MitkoDyakov/Calipatron/README.md

# Calipatorn
I design my own digital caliper based on STM32F103C8T6 blue pill.
