MitkoDyakov/Calipatron/Documents/time.png

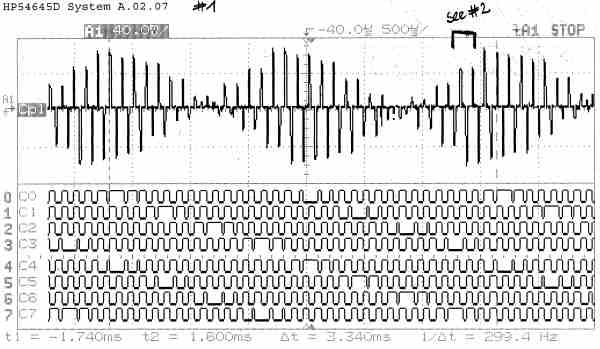
Documents/time.png
