MitkoDyakov/Calipatron/Hardware/V2/blade.step

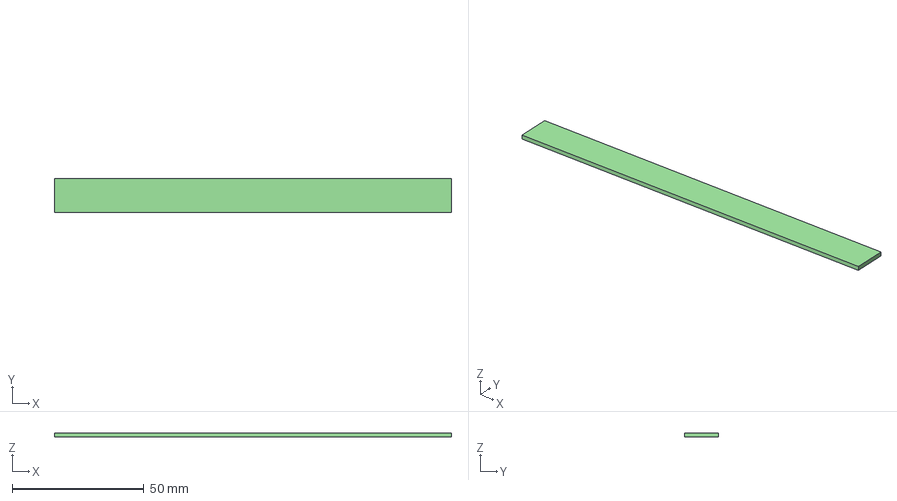
[picture p9: CAD file, 2026-01-22]
Hardware/V2/blade.step
150.6 x 13.0 x 1.60 mm
