MitkoDyakov/Calipatron/Hardware/V2/Res/ADR510ARTZ-REEL7/ADR510ARTZ-REEL7.step

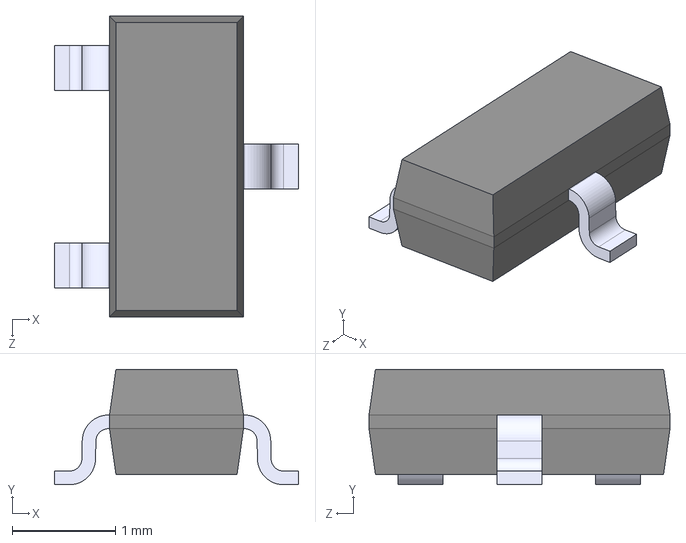
[picture p10: CAD file, 2026-01-22]
Hardware/V2/Res/ADR510ARTZ-REEL7/ADR510ARTZ-REEL7.step
2.37 x 1.12 x 2.92 mm
