MitkoDyakov/Calipatron/Hardware/V2/Res/button/3-1437565-0.step

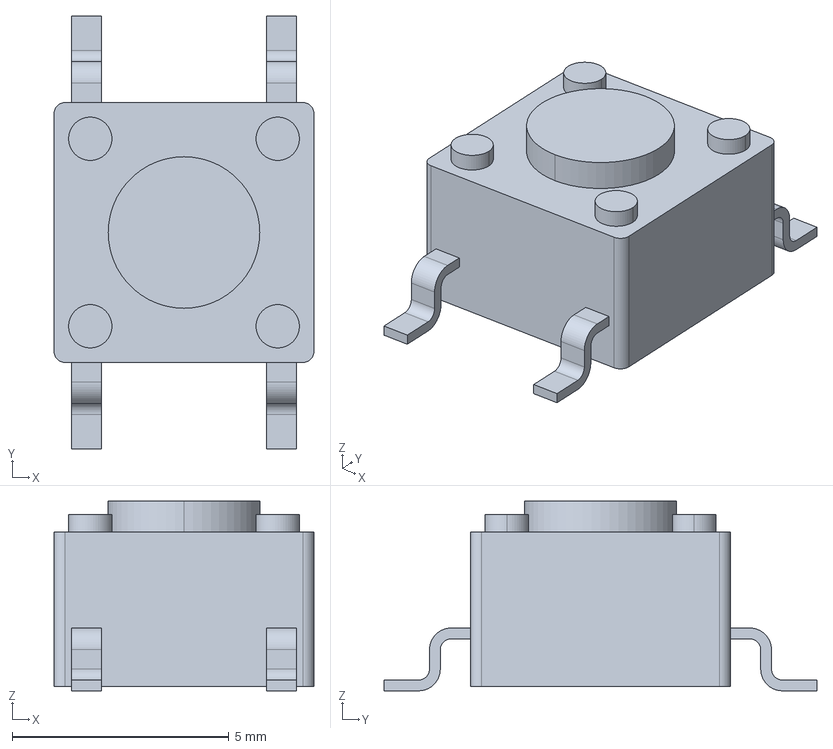
[picture p11: CAD file, 2024-04-25]
Hardware/V2/Res/button/3-1437565-0.step
6.00 x 10.0 x 4.38 mm
