MitkoDyakov/Calipatron/Hardware/V2/Res/HRO_TYPE-C-31-M-12.step

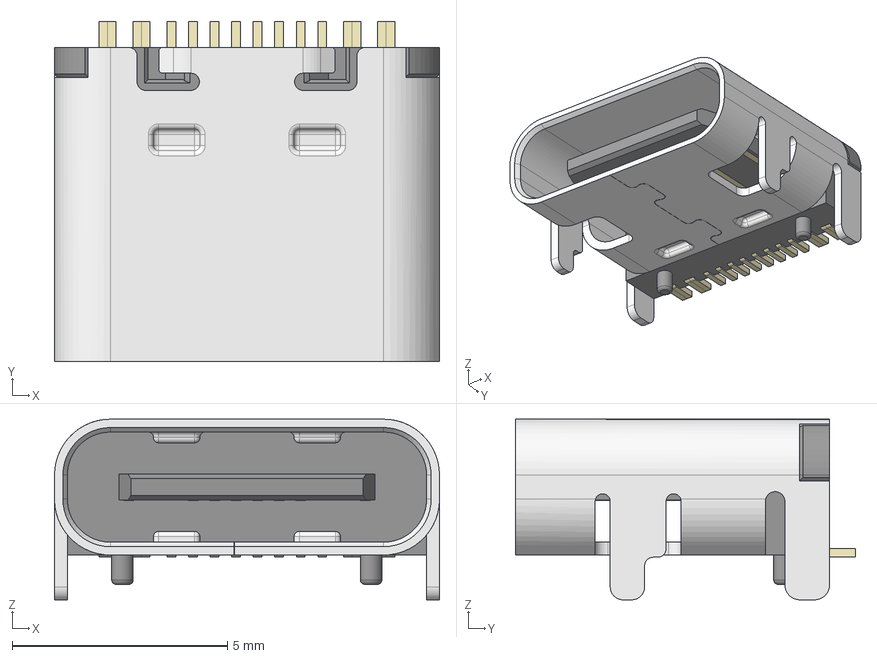
[picture p12: CAD file, 2024-04-25]
Hardware/V2/Res/HRO_TYPE-C-31-M-12.step
8.95 x 7.90 x 4.20 mm
