MitkoDyakov/Calipatron/Hardware/V2/Res/MC-306_32.7680K-A__ROHS/MC-306_32.7680K-A__ROHS.step

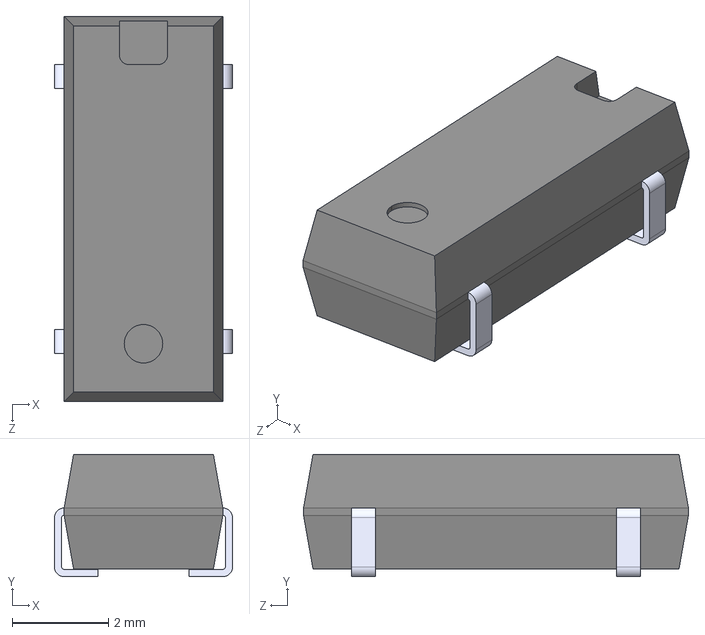
[picture p13: CAD file, 2024-04-25]
Hardware/V2/Res/MC-306_32.7680K-A__ROHS/MC-306_32.7680K-A__ROHS.step
3.70 x 2.54 x 8.00 mm
