MitkoDyakov/Calipatron/Hardware/V2/Res/MCP6S21-I_SN/MCP6S21-I_SN.step

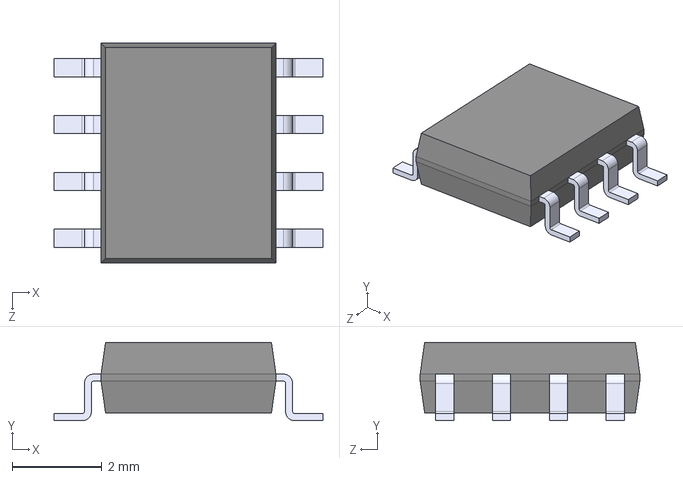
[picture p14: CAD file, 2026-01-22]
Hardware/V2/Res/MCP6S21-I_SN/MCP6S21-I_SN.step
6.00 x 1.75 x 4.90 mm
