MitkoDyakov/Calipatron/Hardware/V2/Res/TSM-104-02-X-SH/TSM-104-02-X-SH.step

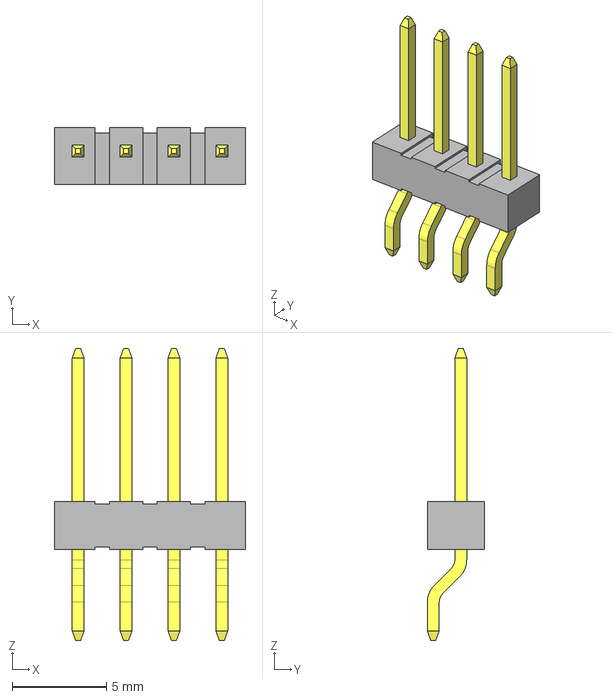
[picture p15: CAD file, 2024-04-25]
Hardware/V2/Res/TSM-104-02-X-SH/TSM-104-02-X-SH.step
10.2 x 3.05 x 15.5 mm
TSM-104-02-SH_body
T-1S6-15(-02-4-SH)
