MitkoDyakov/Calipatron/Hardware/V2/Res/XIAO/ABM3-10.0000MHZ-D2Y-T--3DModel-STEP-400430.STEP

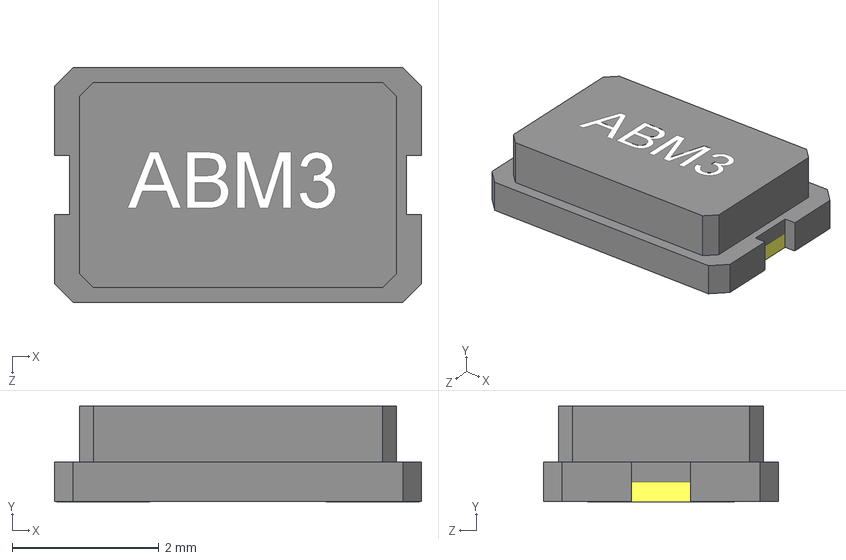
[picture p16: CAD file, 2024-04-25]
Hardware/V2/Res/XIAO/ABM3-10.0000MHZ-D2Y-T--3DModel-STEP-400430.STEP
5.00 x 1.30 x 3.20 mm
