MitkoDyakov/Calipatron/Hardware/V1.0/Step/clip.step

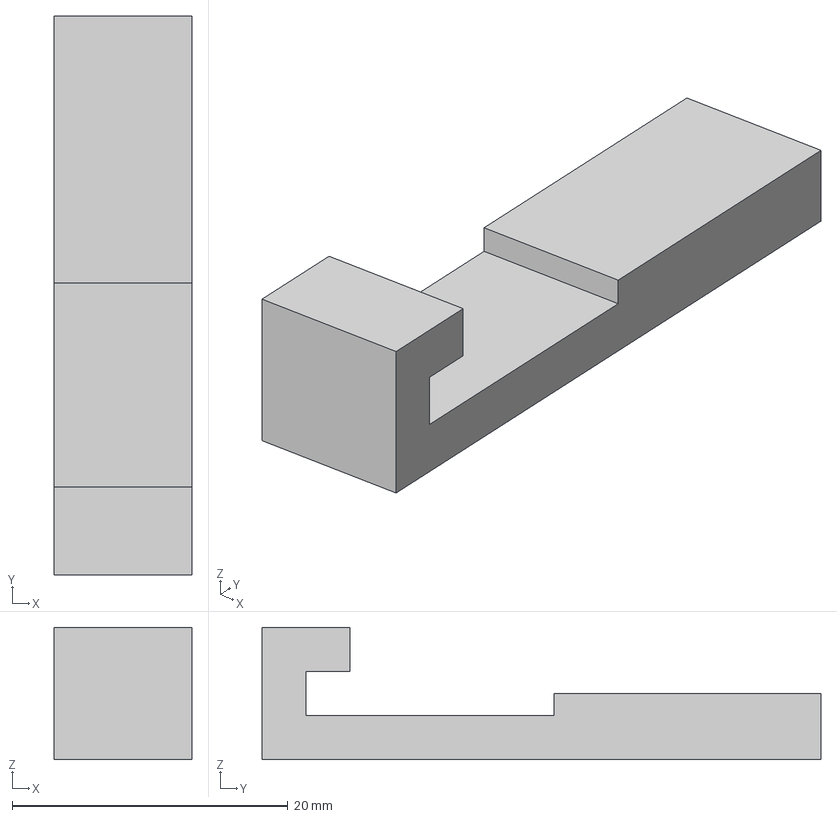
[picture p17: CAD file, 2024-02-12, an earlier design]
Hardware/V1.0/Step/clip.step
10.0 x 40.6 x 9.60 mm
