MitkoDyakov/Calipatron/Hardware/V1.1/Step/CaliperBlade.step

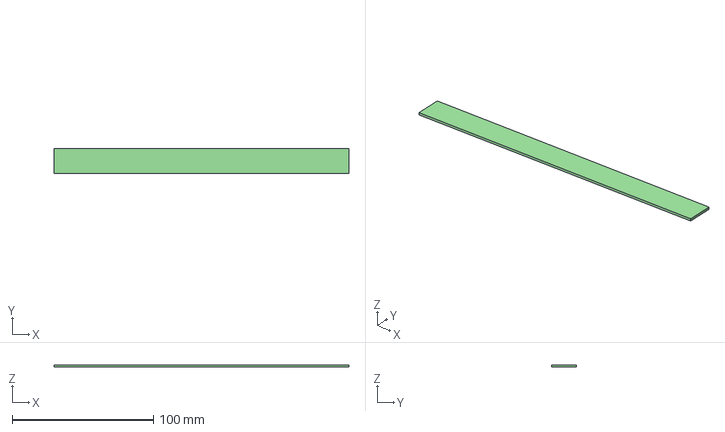
[picture p18: CAD file, 2024-02-12, an earlier design]
Hardware/V1.1/Step/CaliperBlade.step
208.8 x 18.0 x 1.60 mm
