MitkoDyakov/Calipatron/Hardware/V1.2/Step/CaliperBlade.step

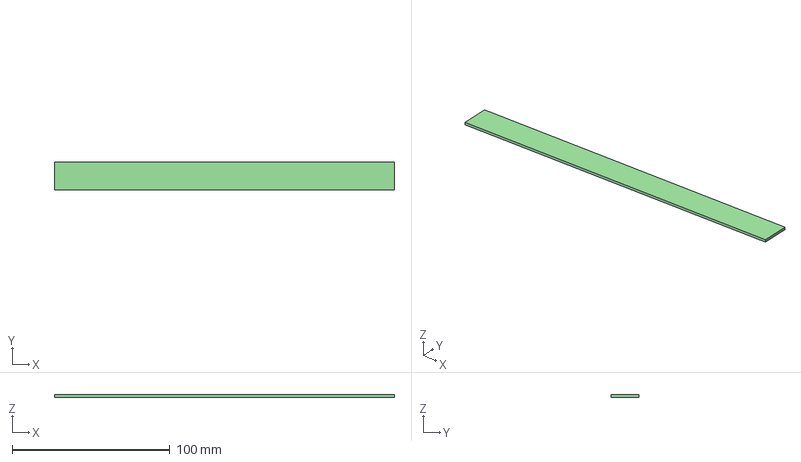
[picture p19: CAD file, 2024-09-15, an earlier design]
Hardware/V1.2/Step/CaliperBlade.step
215.8 x 18.0 x 1.60 mm
