MitkoDyakov/Calipatron/(list of files, cad)

Other CAD files:
Hardware/V1.0/Step/clip.stl
