MitkoDyakov/Calipatron/Software/binary/howto.png

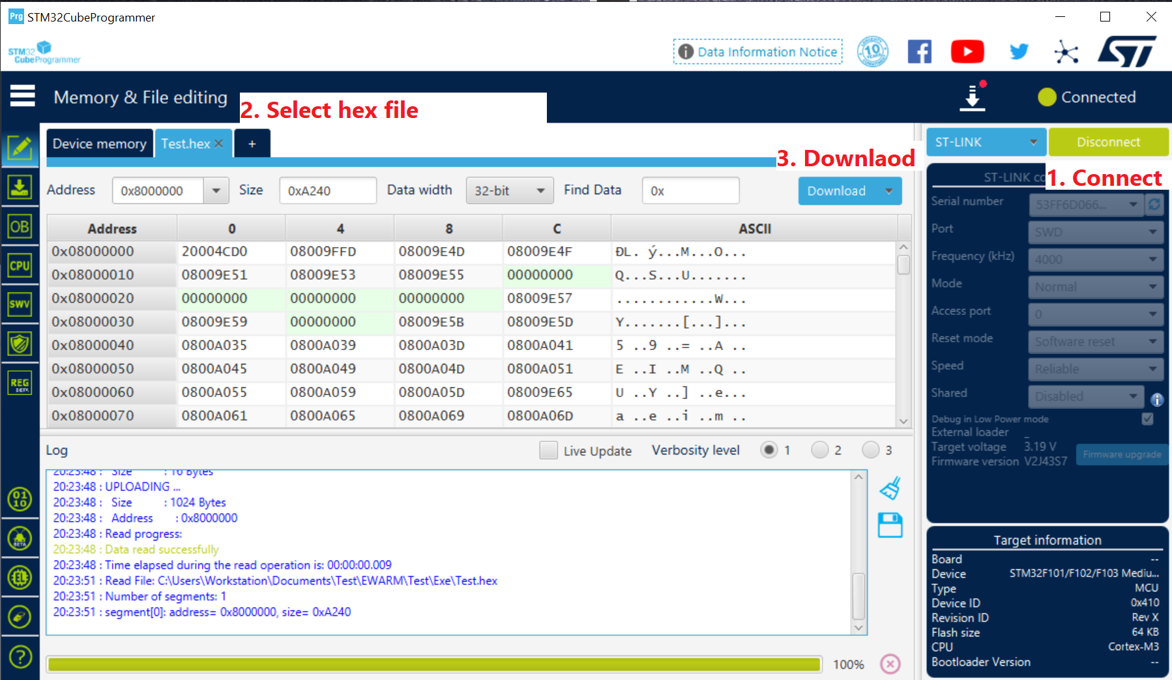
Software/binary/howto.png
