MitkoDyakov/Calipatron/Documents/yadro_timemachine.pdf

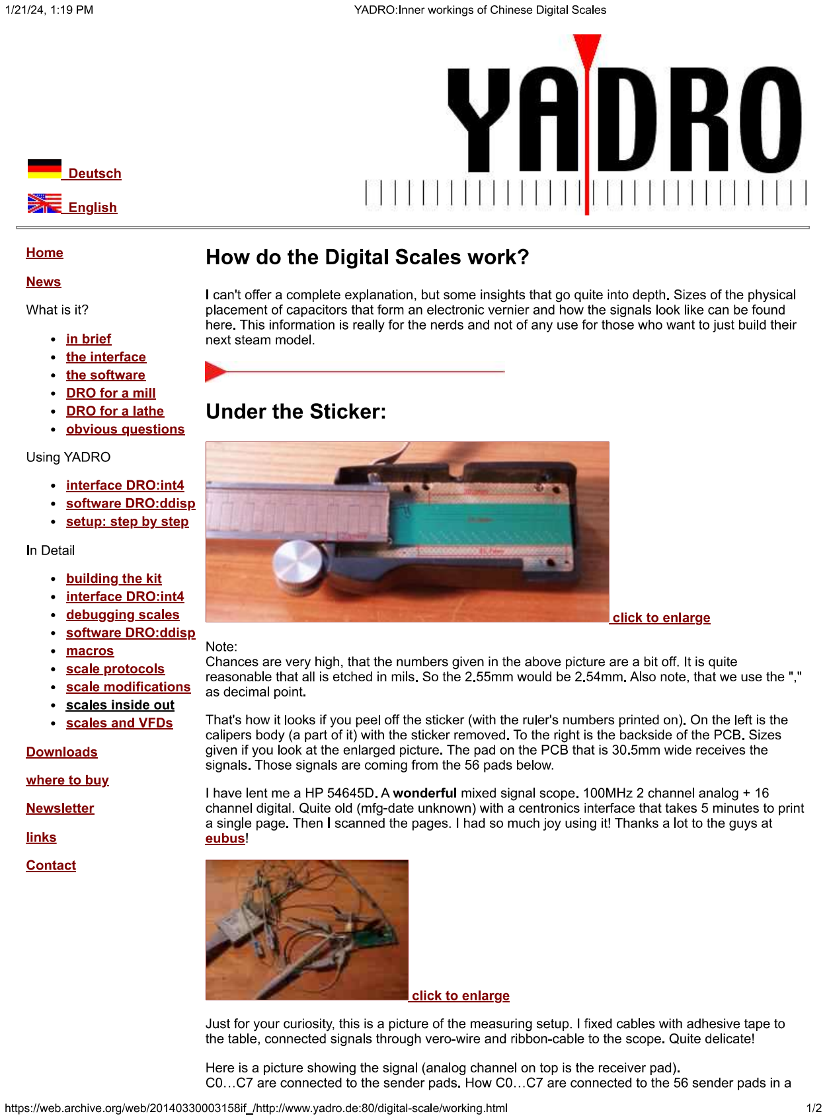
[picture p21: page 1]

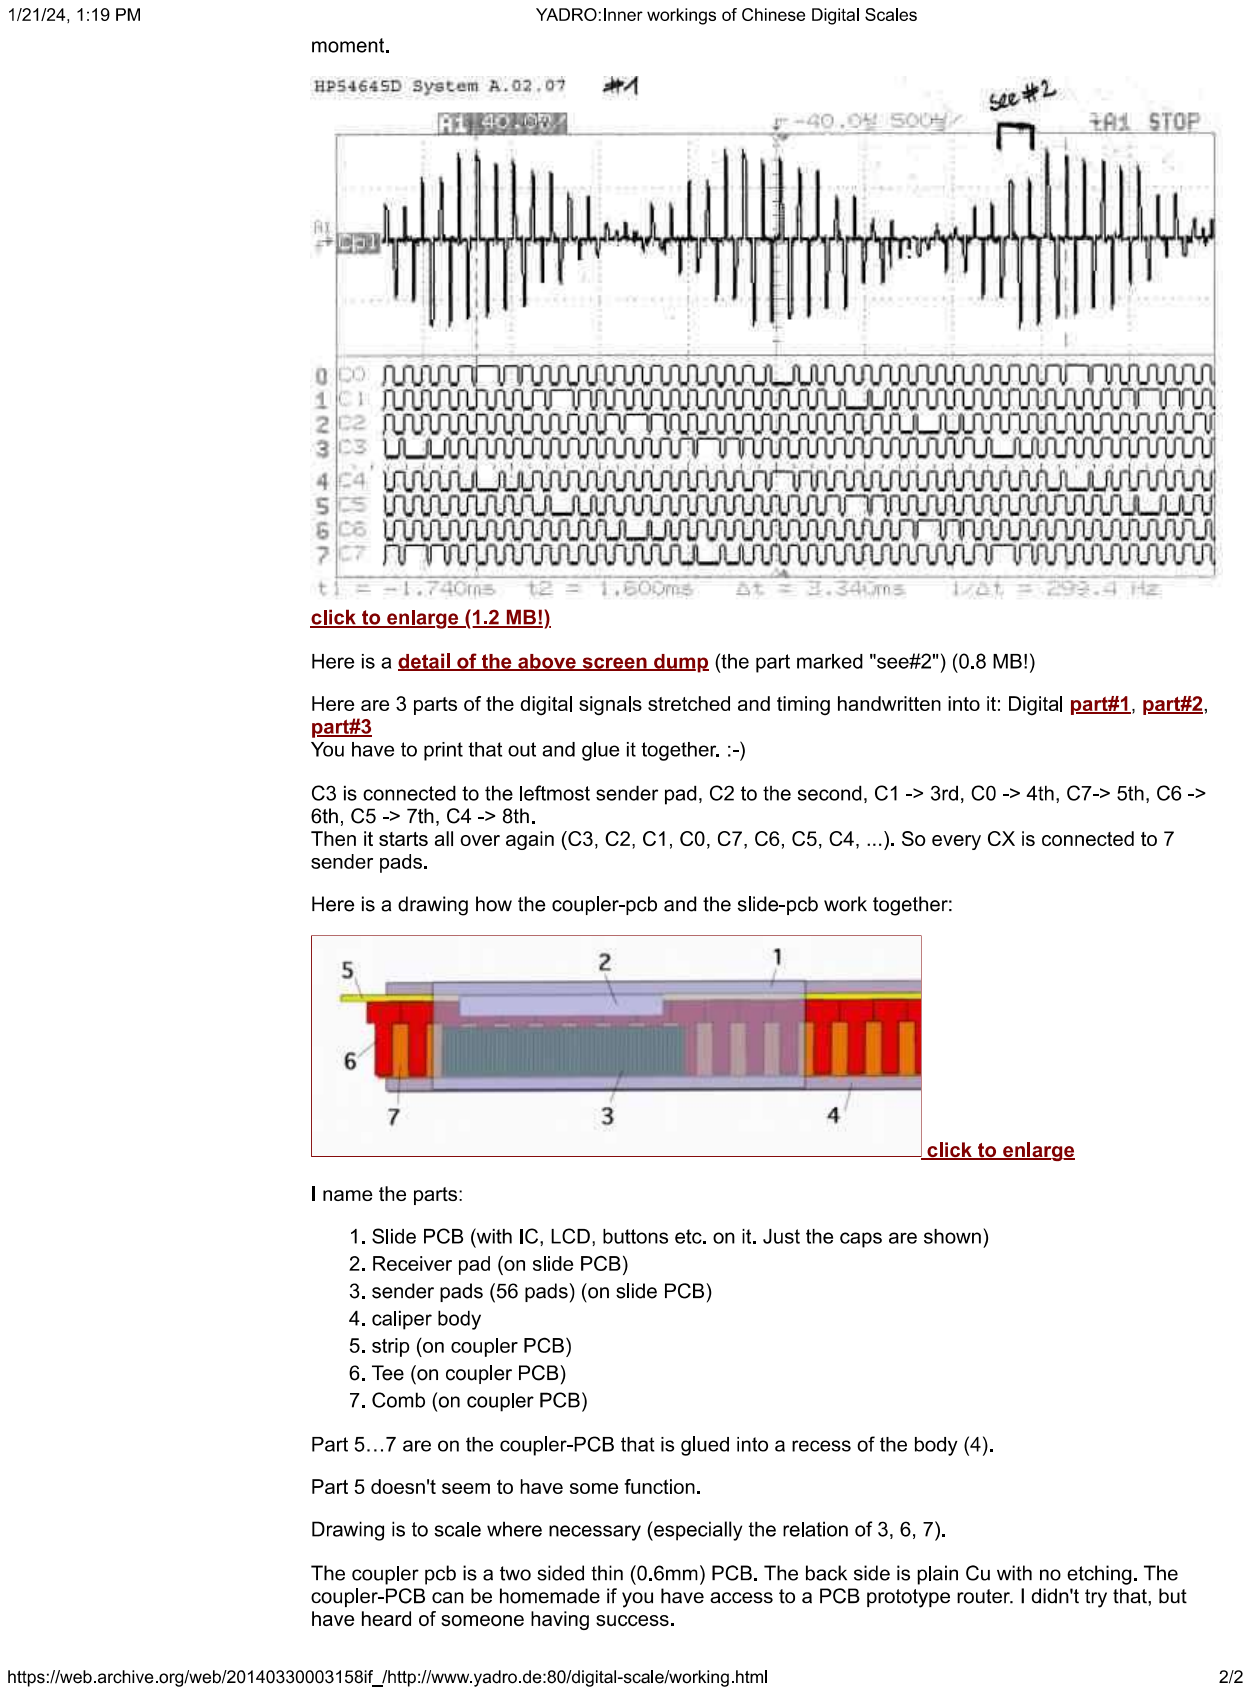
[picture p22: page 2]
