MitkoDyakov/Calipatron/Hardware/V1.2/Schematics V1.2.pdf

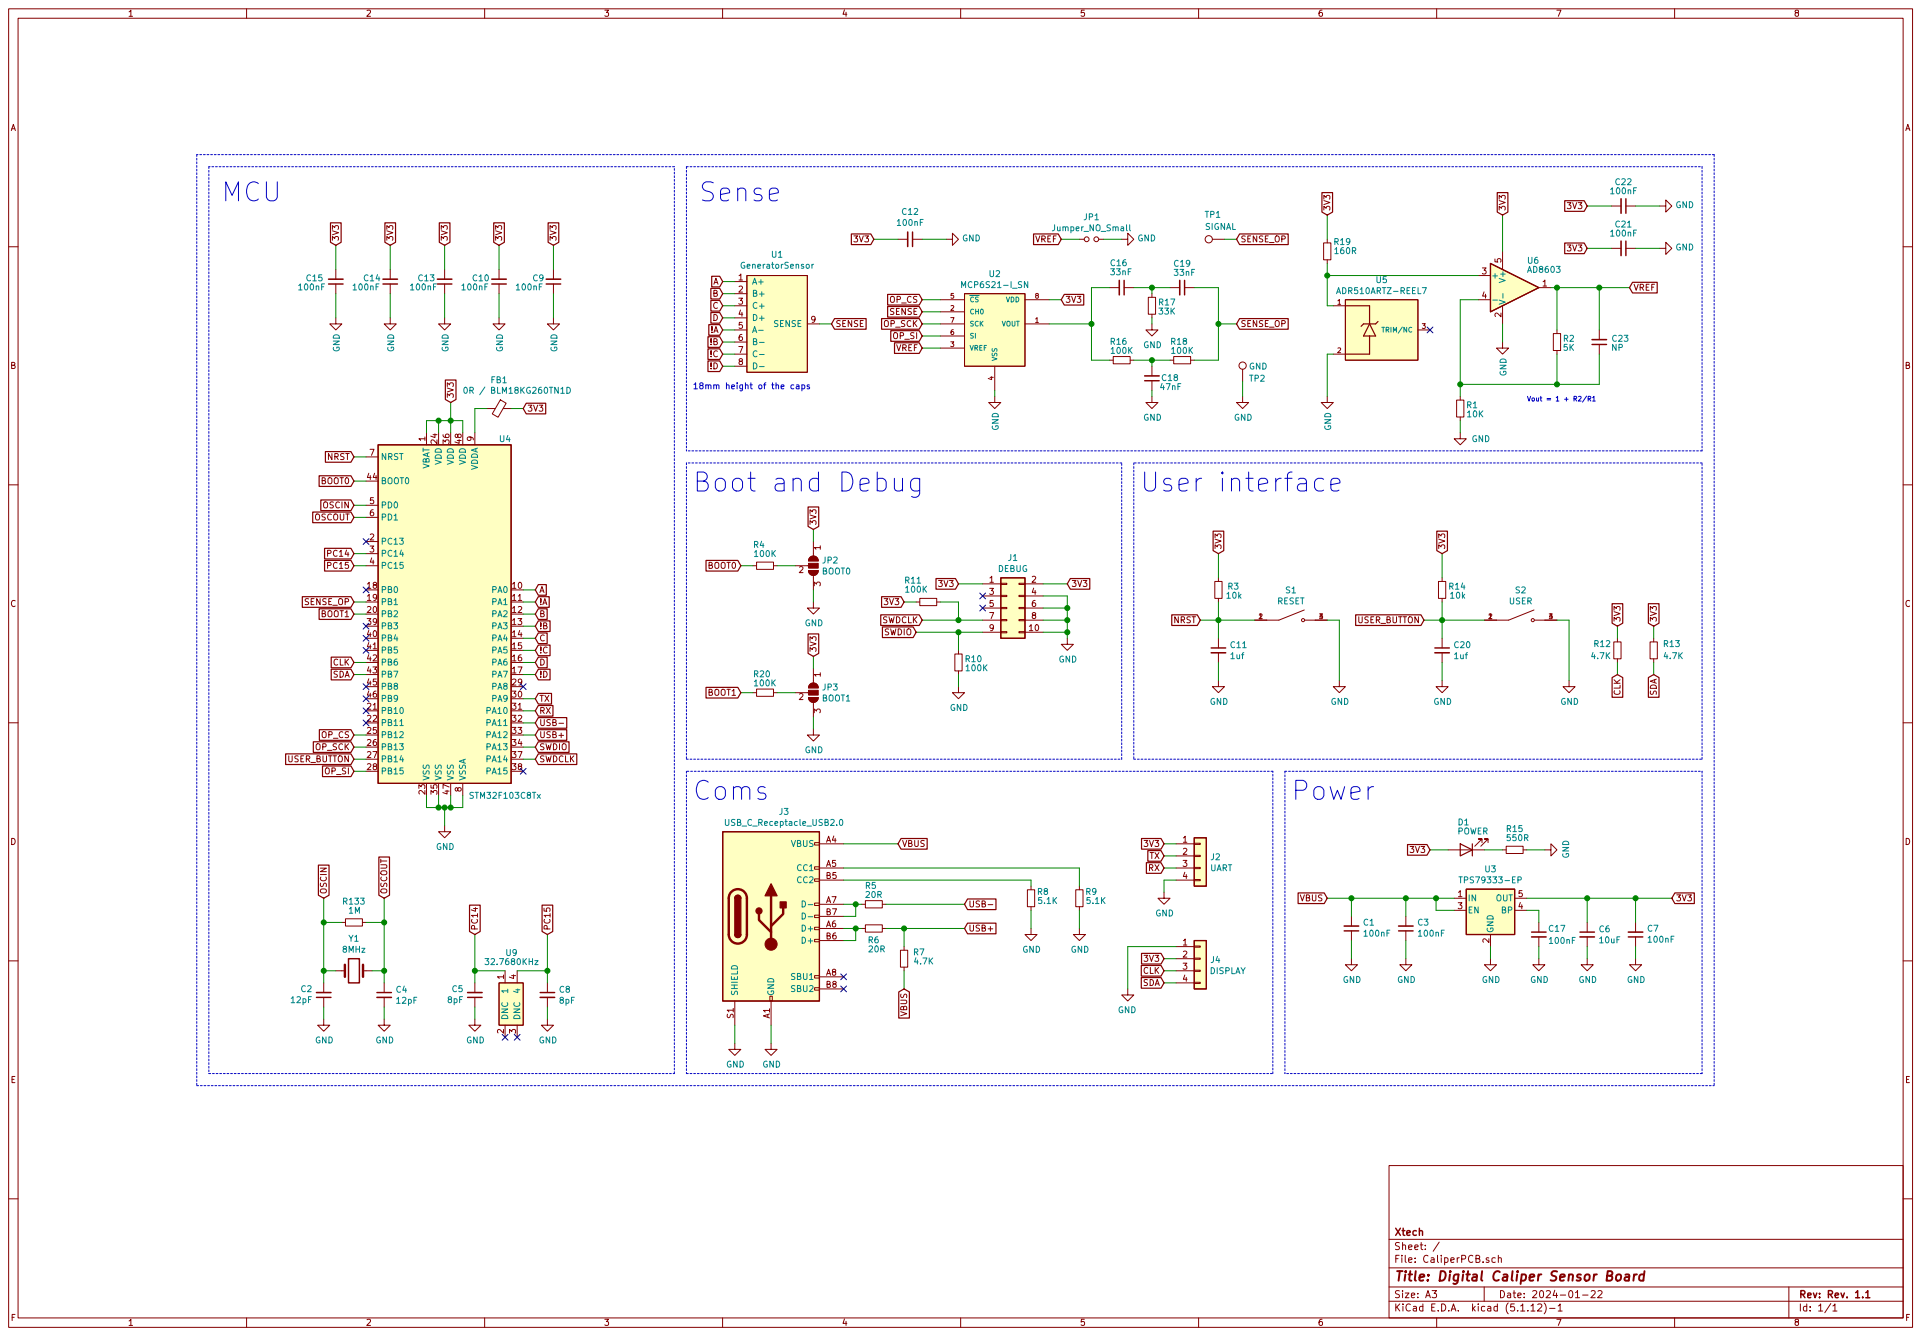
[picture p23: page 1]

4 CS 5 SI 6 SCK 7 VDD 8 U2 MCP6S21-I_SN

1 VDD 24 VDD 36 VDD 48 VDDA

9 VSS 23 VSS 35 VSS 47 VSSA

2 EN 3 BP 4 OUT 5 U3 TPS79333-EP

File: CaliperPCB.sch Sheet: / Xtech

Id: 1/1 Title: Digital Caliper Sensor Board
