MitkoDyakov/Calipatron/Hardware/V1.2/Placement V1.2.pdf

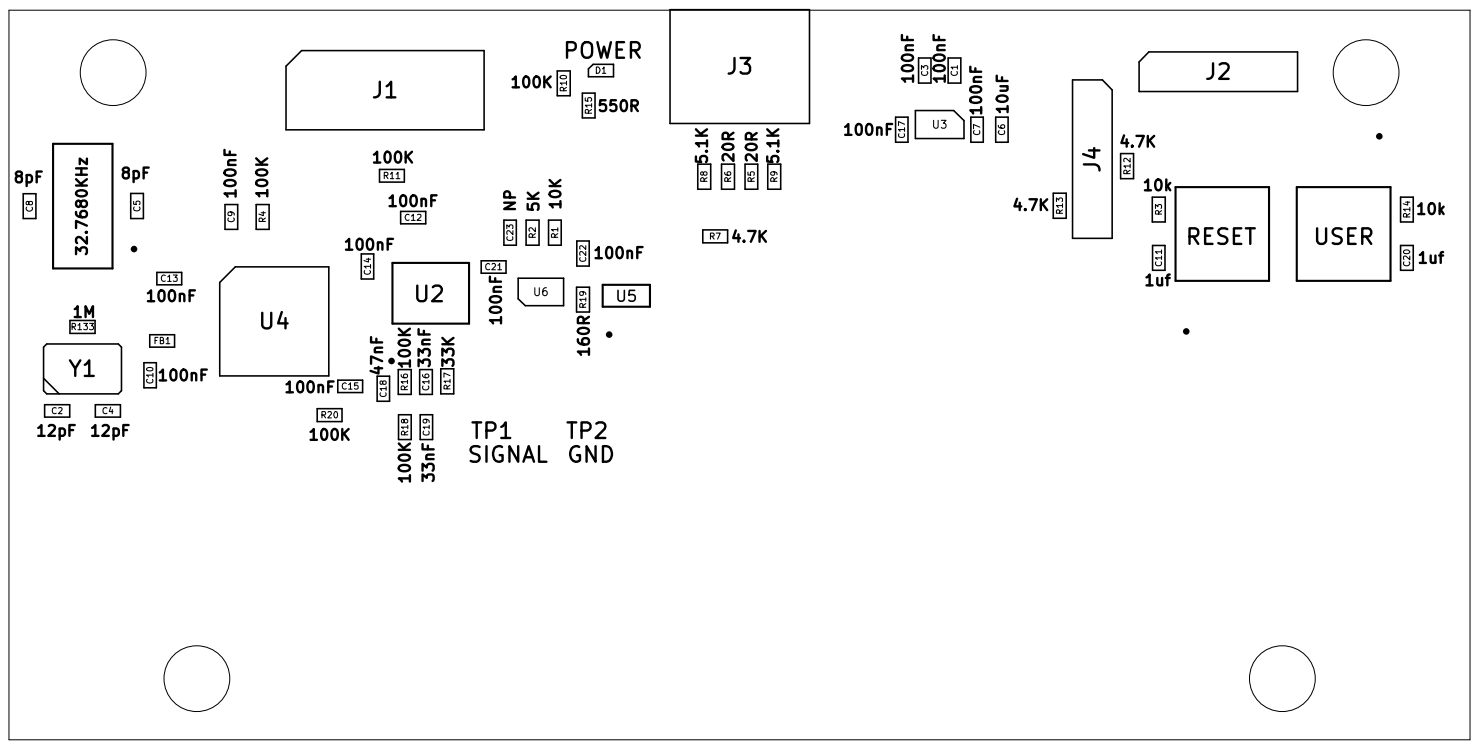
[picture p24: page 1]
