MitkoDyakov/Calipatron/Hardware/V1.1/Placement V1.1.pdf

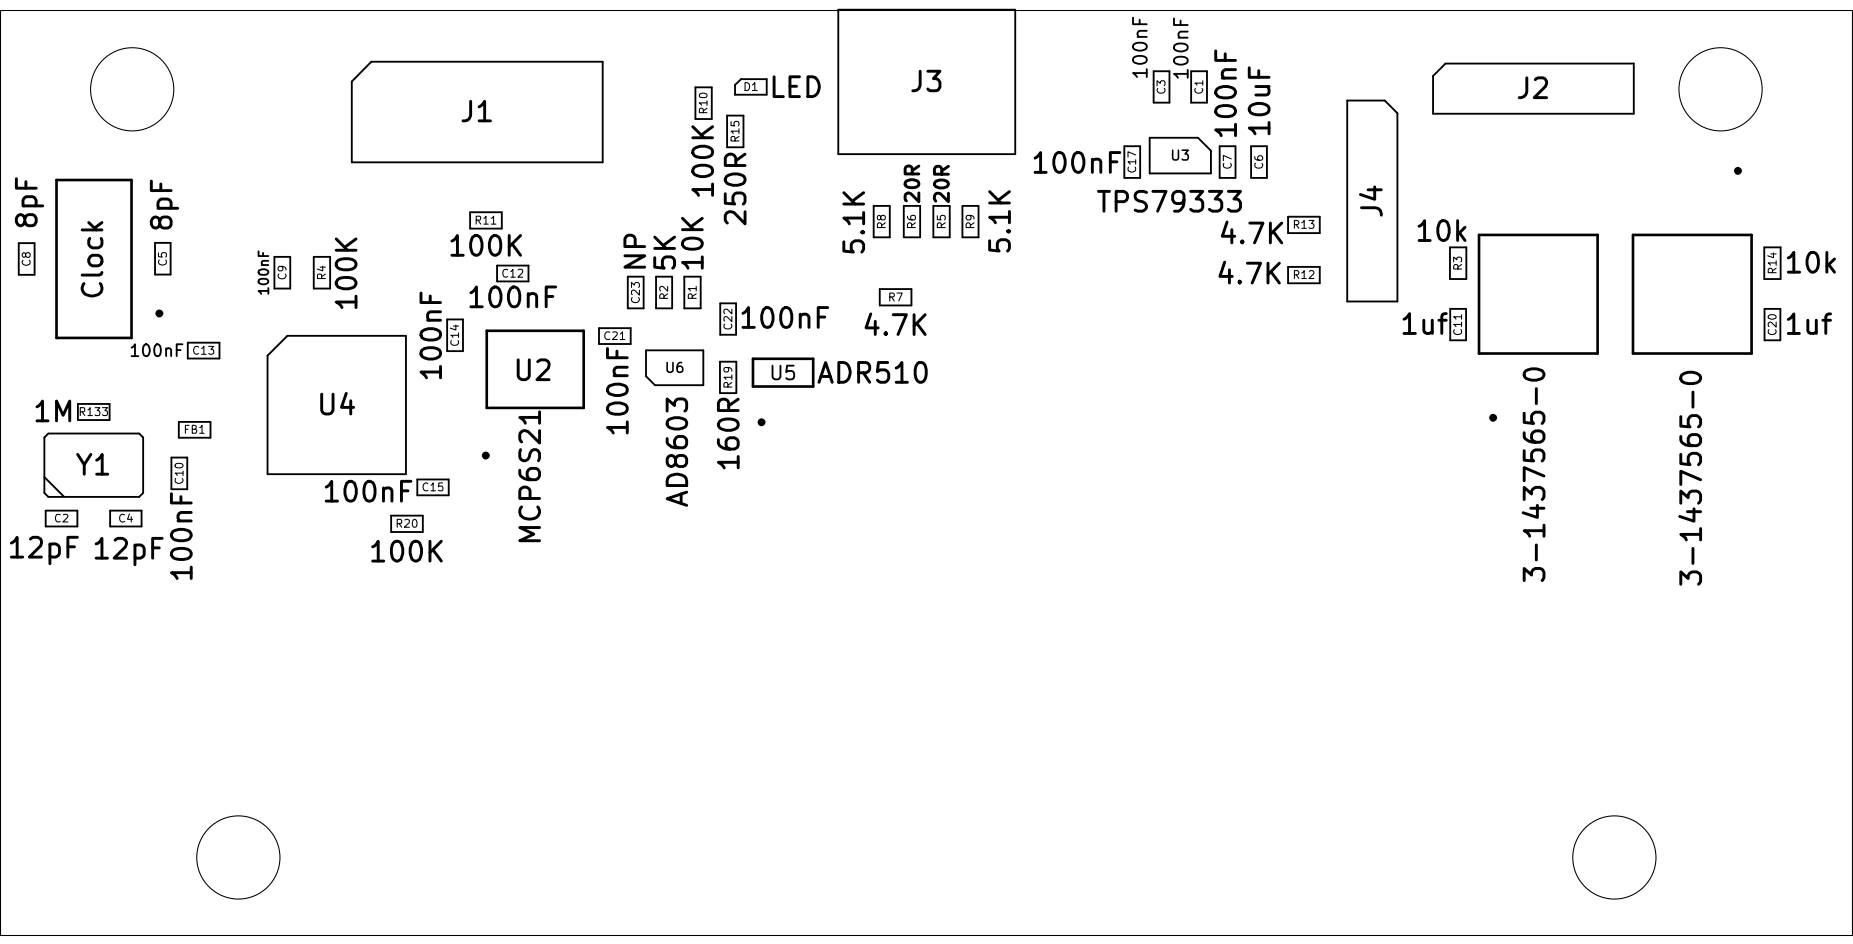
[picture p25: page 1]
