MitkoDyakov/Calipatron/Hardware/V1.0/Caliper BOM and placement V1.pdf

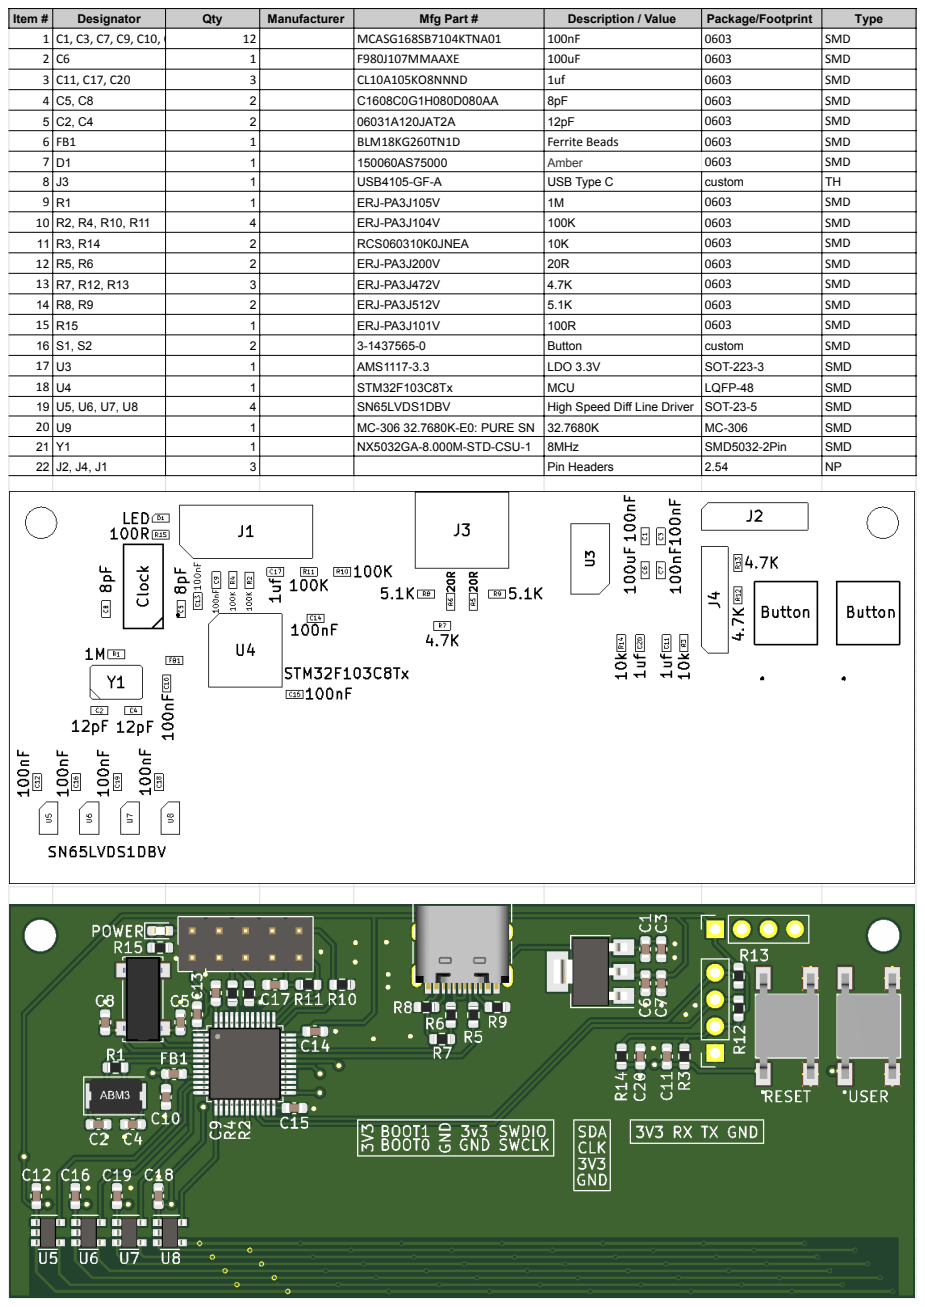
[picture p26: page 1]
