MitkoDyakov/Calipatron/Hardware/V1.0/Schematics V1.pdf

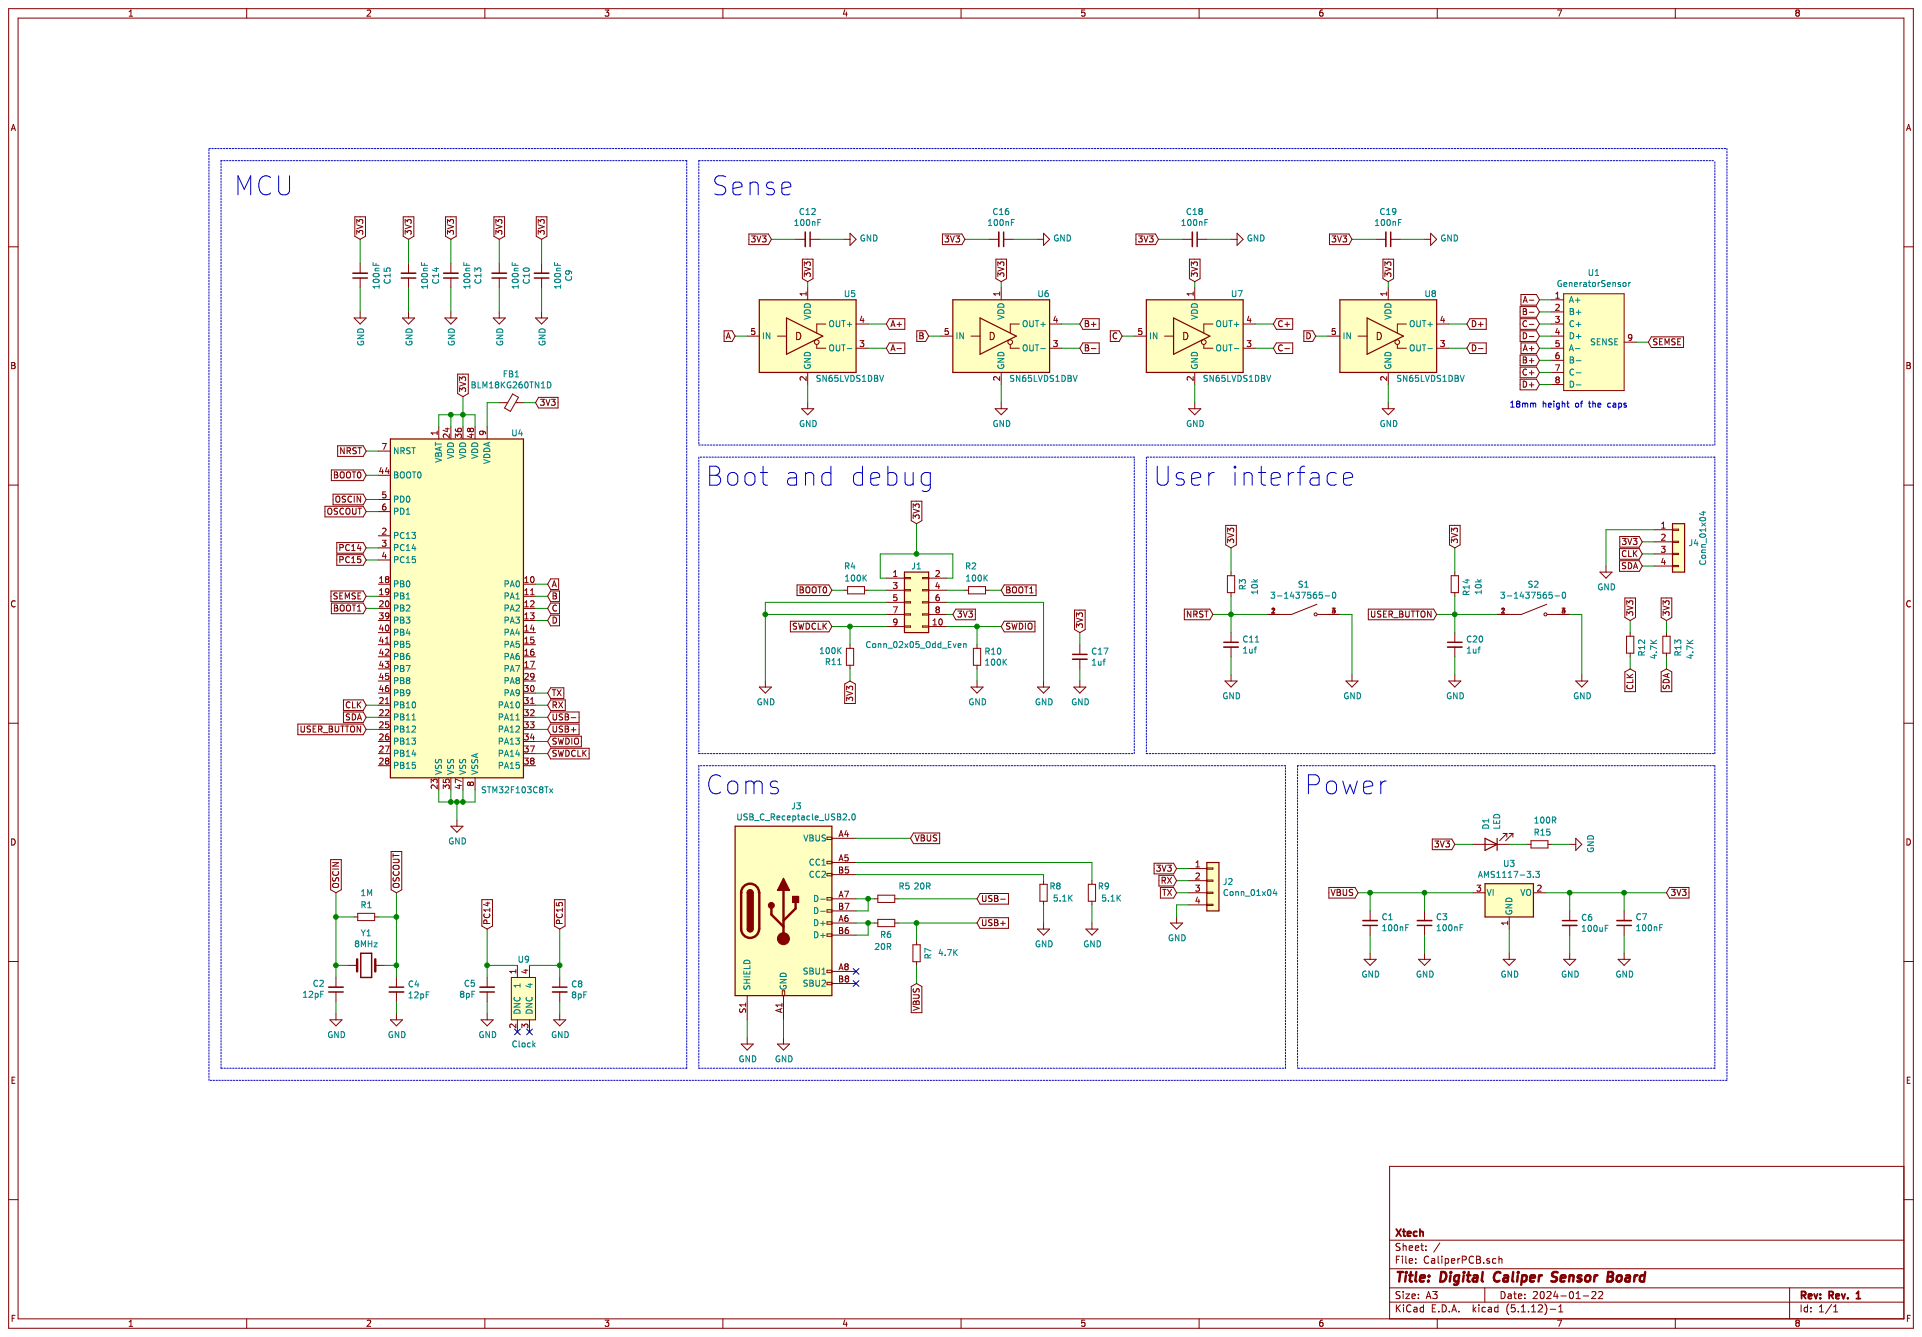
[picture p27: page 1]
