MitkoDyakov/Calipatron/Hardware/V2/Res/XIAO/XIAO ESP32 C6.kicad_pcb

## KiCad design Hardware/V2/Res/XIAO/XIAO ESP32 C6.kicad_pcb (2026-01-22)

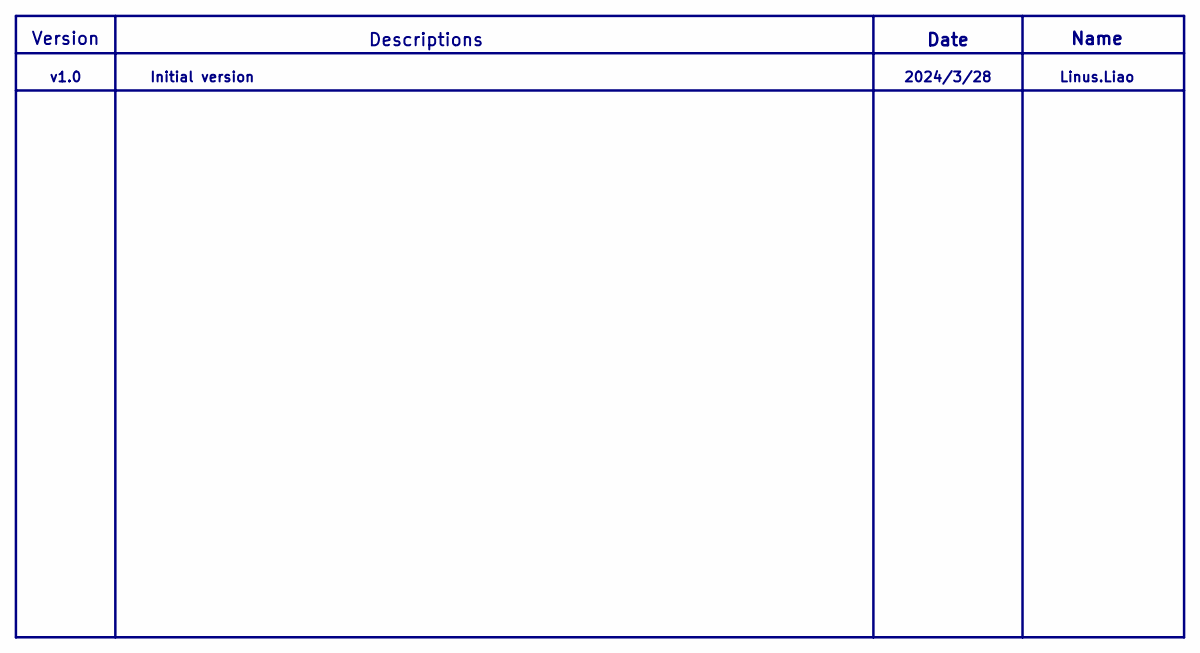
[picture p28: schematic 01 Descriptions.kicad_sch]

Notes on the sheet:
Date
Descriptions
Linus.Liao
2024/3/28
v1.0
Initial version
Name
Version

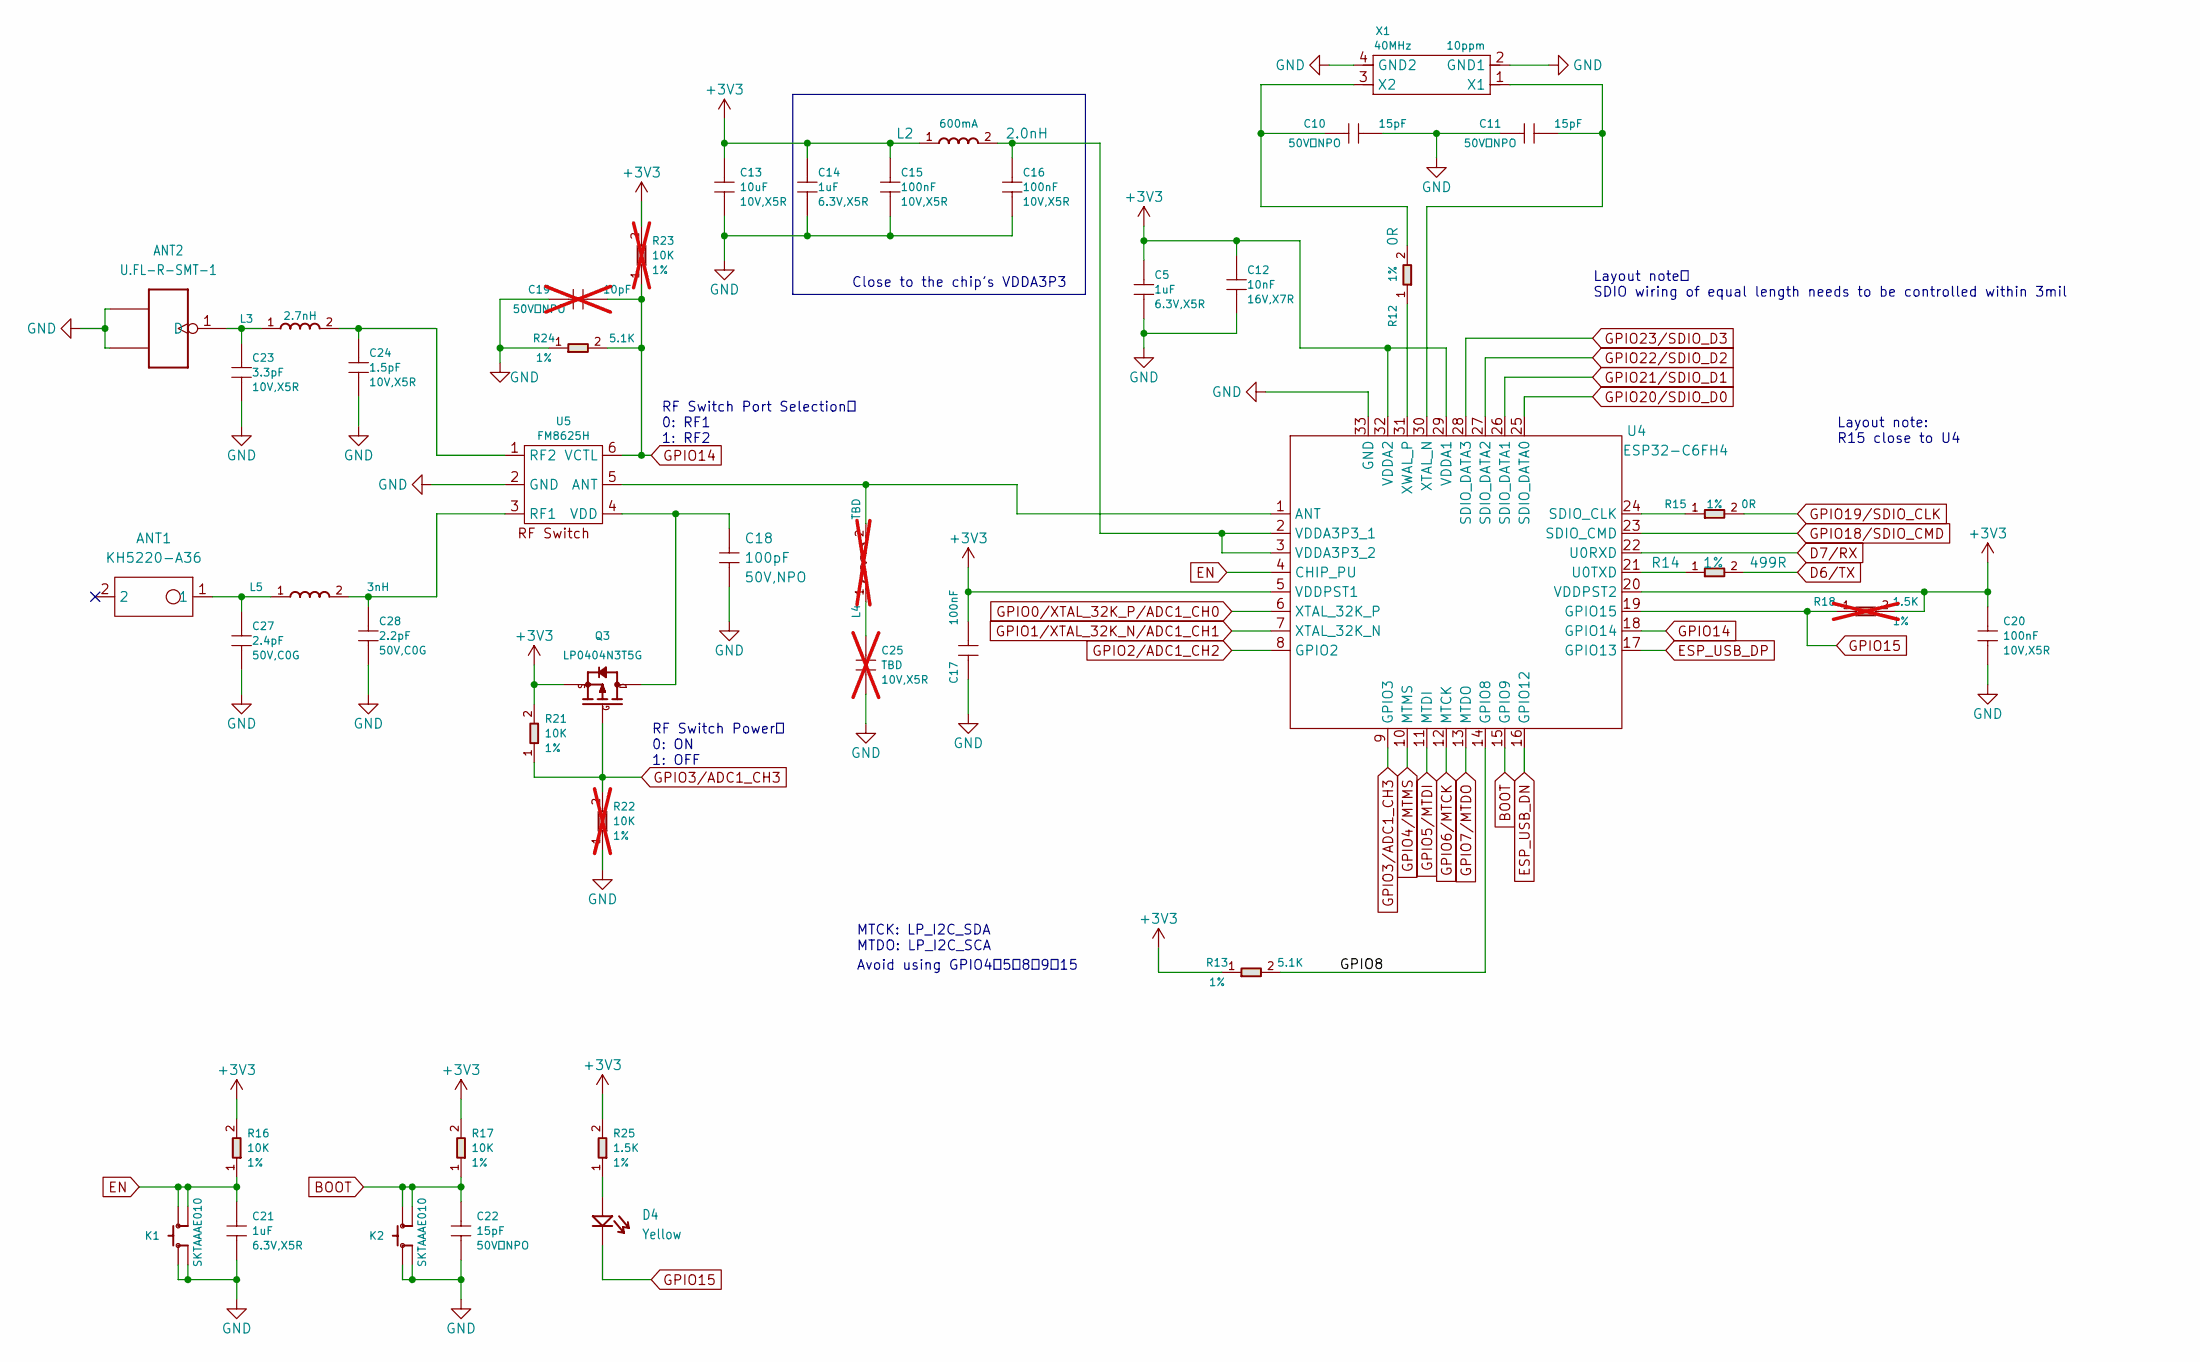
[picture p29: schematic 04 ESP32 C6.kicad_sch]

Parts:
ANT1: KH5220-A36; ANT2P-5.2x2x1.1MM; MPN KH5220-A36
ANT2: U.FL-R-SMT-1; U-FL3P-SMD-2.6X2.6X1.0MM; MPN U.FL-R-SMT-1
C5, C14, C21: 1uF; C0201; Voltage Rating 6.3V,X5R; MPN CC0201MRX5R5BB105
C10, C11, C22: 15pF; C0201; Voltage Rating 50V，NPO; MPN CC0201JRNPO9BN150
C12: 10nF; C0201; Voltage Rating 16V,X7R; MPN CC0201KRX7R7BB103
C13: 10uF; C0402; Voltage Rating 10V,X5R; MPN CC0402MRX5R6BB106
C15, C16, C17, C20: 100nF; C0201; Voltage Rating 10V,X5R; MPN CC0201KRX5R6BB104
C18: 100pF; C0201; Voltage Rating 50V,NPO; MPN CC0201JRNPO9BN101
C19: 10pF; C0201; Voltage Rating 50V，NPO; MPN CC0201JRNPO8BN100; not fitted
C23: 3.3pF; C0201; Voltage Rating 10V,X5R; MPN CQ0201BRNPO8BN3R3
C24: 1.5pF; C0201; Voltage Rating 10V,X5R; MPN CC0201BRNPO9BN1R5
C25: TBD; C0201; Voltage Rating 10V,X5R; Part Type Ceramic; not fitted
C27: 2.4pF; C0201; Voltage Rating 50V,C0G; MPN GRM0335C1H2R4BA01D
C28: 2.2pF; C0201; Voltage Rating 50V,C0G; MPN GRM0335C1H2R2BA01D
D4: Yellow; LED-0402; MPN 16-213/Y2C-AN2Q1B/3T
K1, K2: SKTAAAE010; SW4-SMD-2.8-2.6X1.6X0.53MM; MPN SKTAAAE010
L2: 2.0nH; L0201; Rating 600mA; MPN LQP03HQ2N0B02D
L3: 2.7nH; L0201; MPN LQP03TN2N7B02D
L4: TBD; L0201; Part Type L; not fitted
L5: 3nH; L0201; MPN LQP03TN3N0B02D
Q3: LP0404N3T5G; PMOS_1.0X0.6X0.35MM; MPN LP0404N3T5G
R12, R15: 0R; R0201; Power Rating 1%; MPN RC0201FR-070RL
R13, R24: 5.1K; R0201; Power Rating 1%; MPN RC0201FR-075K1L
R14: 499R; R0201; Power Rating 1%; MPN RC0201FR-07499RL
R16, R17, R21: 10K; R0201; Power Rating 1%; MPN RC0201FR-0710KL
R18: 1.5K; R0201; Power Rating 1%; MPN RC0201FR-071K5L; not fitted
R22, R23: 10K; R0201; Power Rating 1%; MPN RC0201FR-0710KL; not fitted
R25: 1.5K; R0201; Power Rating 1%; MPN RC0201FR-071K5L
U4: ESP32-C6FH4; QFN32-0.5-5X5MM; MPN ESP32-C6FH4
U5: FM8625H; DFN6-0.4-1.1X0.7X0.45MM; MPN FM8625H
X1: 40MHz; X4-SMD-1.6X1.2MM; Rating 10ppm; MPN CJ17-400001010B20

Connections:
+3V3: C5.1, C12.1, C13.1, C14.1, C15.1, C17.1, C20.1, L2.1, Q3.2 (S), R13.1, R16.2, R17.2, R18.2, R21.2, R23.2, R25.2, U4.5 (VDDPST1), U4.20 (VDDPST2), U4.29 (VDDA1), U4.32 (VDDA2); also elsewhere on the board
/04 ESP32 C6/GPIO8: R13.2, U4.14 (GPIO8)
BOOT: C22.1, K2.3 (B0), K2.4 (B1), R17.1, U4.15 (GPIO9); also elsewhere on the board
D6/TX: R14.2; also elsewhere on the board
D7/RX: U4.22 (U0RXD); also elsewhere on the board
EN: C21.1, K1.3 (B0), K1.4 (B1), R16.1, U4.4 (CHIP_PU); also elsewhere on the board
ESP_USB_DN: U4.16 (GPIO12); also elsewhere on the board
ESP_USB_DP: U4.17 (GPIO13); also elsewhere on the board
GND: ANT2.2 (GND1), ANT2.3 (GND2), C5.2, C10.2, C11.1, C12.2, C13.2, C14.2, C15.2, C16.2, C17.2, C18.2, C19.1, C20.2, C21.2, C22.2, C23.2, C24.2, C25.2, C27.2, C28.2, K1.1 (A0), K1.2 (A1), K2.1 (A0), K2.2 (A1), R22.1, R24.1, U4.33 (GND), U5.2 (GND), X1.2 (GND1), X1.4 (GND2); also elsewhere on the board
GPIO0/XTAL_32K_P/ADC1_CH0: U4.6 (XTAL_32K_P); also elsewhere on the board
GPIO1/XTAL_32K_N/ADC1_CH1: U4.7 (XTAL_32K_N); also elsewhere on the board
GPIO2/ADC1_CH2: U4.8 (GPIO2); also elsewhere on the board
GPIO3/ADC1_CH3: Q3.1 (G), R21.1, R22.2, U4.9 (GPIO3)
GPIO4/MTMS: U4.10 (MTMS); also elsewhere on the board
GPIO5/MTDI: U4.11 (MTDI); also elsewhere on the board
GPIO6/MTCK: U4.12 (MTCK); also elsewhere on the board
GPIO7/MTDO: U4.13 (MTDO); also elsewhere on the board
GPIO14: C19.2, R23.1, R24.2, U4.18 (GPIO14), U5.6 (VCTL)
GPIO15: D4.2 (-), R18.1, U4.19 (GPIO15)
GPIO18/SDIO_CMD: U4.23 (SDIO_CMD); also elsewhere on the board
GPIO19/SDIO_CLK: R15.2; also elsewhere on the board
GPIO20/SDIO_D0: U4.25 (SDIO_DATA0); also elsewhere on the board
GPIO21/SDIO_D1: U4.26 (SDIO_DATA1); also elsewhere on the board
GPIO22/SDIO_D2: U4.27 (SDIO_DATA2); also elsewhere on the board
GPIO23/SDIO_D3: U4.28 (SDIO_DATA3); also elsewhere on the board
unnamed: ANT1.1, C27.1, L5.1
unnamed: ANT2.1 (D), C23.1, L3.1
unnamed: C25.1, L4.1
unnamed: D4.1 (+), R25.1
unnamed: C18.1, Q3.3 (D), U5.4 (VDD)
unnamed: L4.2, U4.1 (ANT), U5.5 (ANT)
unnamed: R15.1, U4.24 (SDIO_CLK)
unnamed: R14.1, U4.21 (U0TXD)
unnamed: C16.1, L2.2, U4.2 (VDDA3P3_1), U4.3 (VDDA3P3_2)
unnamed: C11.2, U4.30 (XTAL_N), X1.1 (X1)
unnamed: R12.1, U4.31 (XWAL_P)
unnamed: C28.1, L5.2, U5.3 (RF1)
unnamed: C24.1, L3.2, U5.1 (RF2)
unnamed: C10.1, R12.2, X1.3 (X2)

Notes on the sheet:
Avoid using GPIO4、5、8、9、15
RF Switch Power： 0: ON 1: OFF
Layout note: R15 close to U4
Close to the chip's VDDA3P3
Layout note： SDIO wiring of equal length needs to be controlled within 3mil
RF Switch Port Selection： 0: RF1 1: RF2
MTCK: LP_I2C_SDA MTDO: LP_I2C_SCA

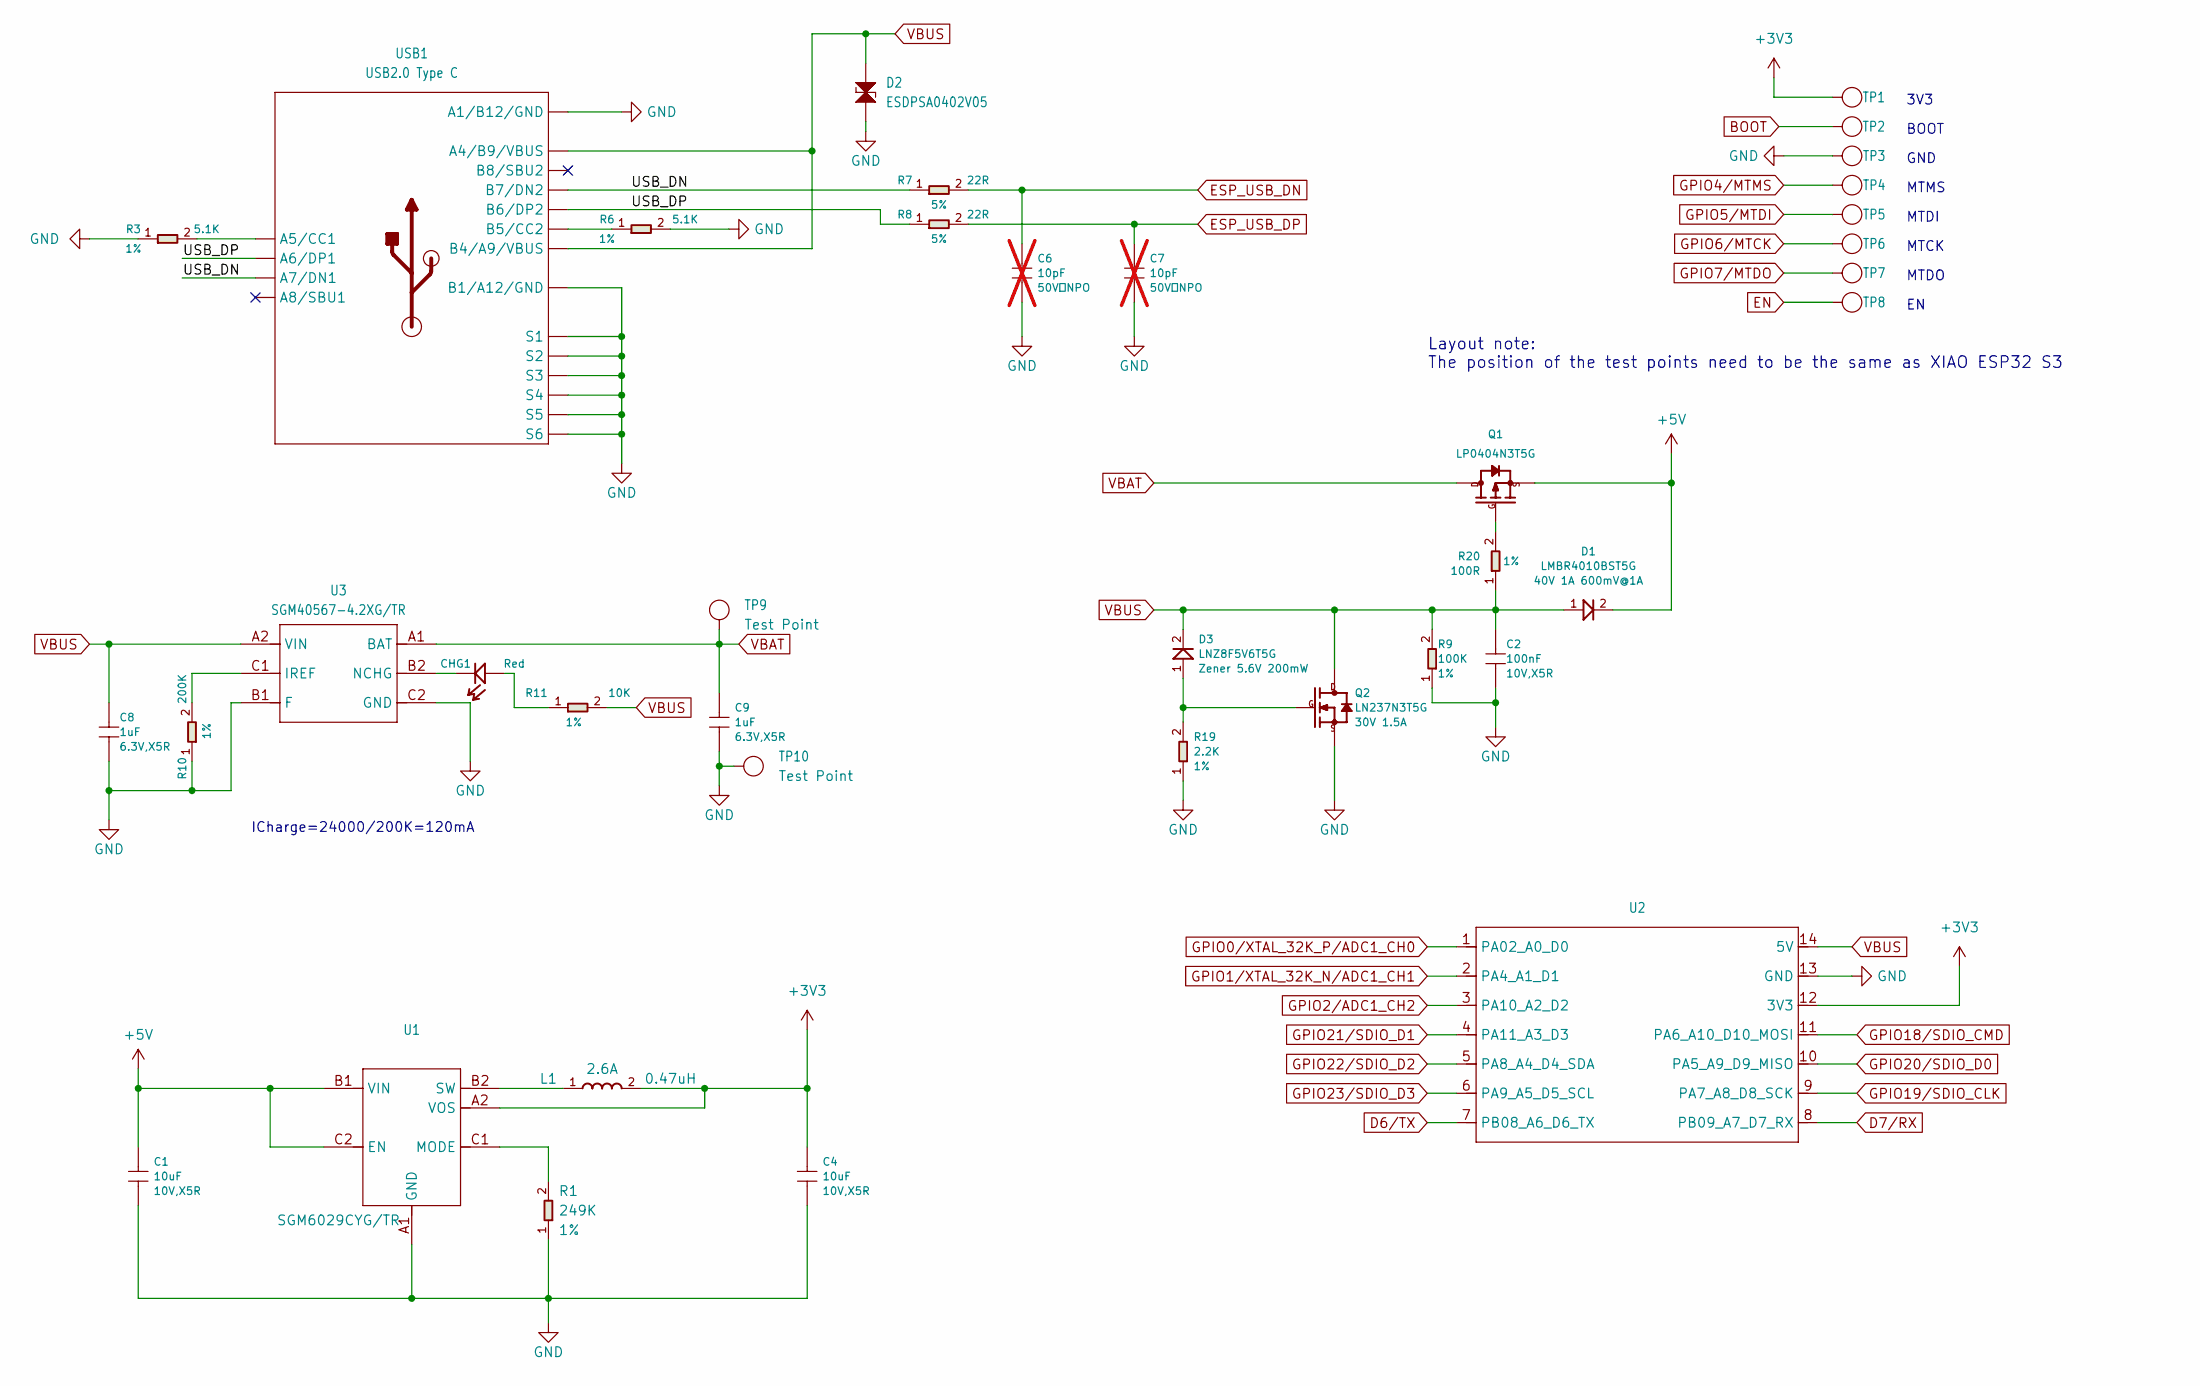
[picture p30: schematic 03 Power.kicad_sch]

Parts:
C1, C4: 10uF; C0402; Voltage Rating 10V,X5R; MPN CC0402MRX5R6BB106
C2: 100nF; C0201; Voltage Rating 10V,X5R; MPN CC0201KRX5R6BB104
C6, C7: 10pF; C0201; Voltage Rating 50V，NPO; MPN CC0201JRNPO8BN100; not fitted
C8, C9: 1uF; C0201; Voltage Rating 6.3V,X5R; MPN CC0201MRX5R5BB105
CHG1: Red; LED-0402; MPN BL-HUB37A-AV-TRB
D1: LMBR4010BST5G; DFN1006-2L; Rating 40V 1A 600mV@1A; MPN LMBR4010BST5G
D2: ESDPSA0402V05; ESD-0402; MPN ESDPSA0402V05
D3: LNZ8F5V6T5G; DFN1006-2L; Rating Zener 5.6V 200mW; MPN LNZ8F5V6T5G
L1: 0.47uH; L0603; Rating 2.6A; MPN TFM160808ALC-R47MTAA
Q1: LP0404N3T5G; PMOS_1.0X0.6X0.35MM; MPN LP0404N3T5G
Q2: LN237N3T5G; PMOS_1.0X0.6X0.35MM; Rating 30V 1.5A; MPN LN237N3T5G
R1: 249K; R0201; Power Rating 1%; MPN RC0201FR-07249KL
R3, R6: 5.1K; R0201; Power Rating 1%; MPN RC0201FR-075K1L
R7, R8: 22R; R0201; Power Rating 5%; MPN RC0201JR-0722RL
R9: 100K; R0201; Power Rating 1%; MPN RC0201FR-07100KL
R10: 200K; R0201; Power Rating 1%; MPN RC0201FR-07200KL
R11: 10K; R0201; Power Rating 1%; MPN RC0201FR-0710KL
R19: 2.2K; R0201; Power Rating 1%; MPN RC0201FR-072K2L
R20: 100R; R0201; Power Rating 1%; MPN RC0201FR-07100RL
TP1, TP2, TP3, TP4, TP5, TP6, TP7, TP8: Test Point; TP-D45MIL; Part Type Test Point
TP9, TP10: Test Point; TP-80X40MIL; Part Type Test Point
U1: SMD IC PMIC;DCDC Buck-ADJ-1A,Vin 1.95V to 5.5V,Vo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; BGA6-0.35-0.745X10.95X0.4MM; MPN SGM6029CYG/TR
U2: MOUDLE14P-XIAO-HALF-HOLE
U3: SGM40567-4.2XG/TR; WLCSP-0.4-0.92X1.16X0.4MM; MPN SGM40567-4.2XG/TR
USB1: USB2.0 Type C; USB2.0-TYPE-C; MPN UBF31-0171

Connections:
+3V3: C4.1, L1.2, TP1.1 (T), U1.A2 (VOS), U2.12 (3V3); also elsewhere on the board
+5V: C1.1, D1.2, Q1.2 (S), U1.B1 (VIN), U1.C2 (EN)
/03 Power/USB_DN: R7.1, USB1.A7 (A7/DN1), USB1.B7 (B7/DN2)
/03 Power/USB_DP: R8.1, USB1.A6 (A6/DP1), USB1.B6 (B6/DP2)
BOOT: TP2.1 (T); also elsewhere on the board
D6/TX: U2.7 (PB08_A6_D6_TX); also elsewhere on the board
D7/RX: U2.8 (PB09_A7_D7_RX); also elsewhere on the board
EN: TP8.1 (T); also elsewhere on the board
ESP_USB_DN: C6.1, R7.2; also elsewhere on the board
ESP_USB_DP: C7.1, R8.2; also elsewhere on the board
GND: C1.2, C2.2, C4.2, C6.2, C7.2, C8.2, C9.2, D2.1, Q2.2 (S), R1.1, R3.1, R6.2, R9.1, R10.1, R19.1, TP3.1 (T), TP10.1 (T), U1.A1 (GND), U2.13 (GND), U3.B1 (F), U3.C2 (GND), USB1.A1_B12 (A1/B12/GND), USB1.B1_A12 (B1/A12/GND), USB1.S1, USB1.S2, USB1.S3, USB1.S4, USB1.S5, USB1.S6; also elsewhere on the board
GPIO0/XTAL_32K_P/ADC1_CH0: U2.1 (PA02_A0_D0); also elsewhere on the board
GPIO1/XTAL_32K_N/ADC1_CH1: U2.2 (PA4_A1_D1); also elsewhere on the board
GPIO2/ADC1_CH2: U2.3 (PA10_A2_D2); also elsewhere on the board
GPIO4/MTMS: TP4.1 (T); also elsewhere on the board
GPIO5/MTDI: TP5.1 (T); also elsewhere on the board
GPIO6/MTCK: TP6.1 (T); also elsewhere on the board
GPIO7/MTDO: TP7.1 (T); also elsewhere on the board
GPIO18/SDIO_CMD: U2.11 (PA6_A10_D10_MOSI); also elsewhere on the board
GPIO19/SDIO_CLK: U2.9 (PA7_A8_D8_SCK); also elsewhere on the board
GPIO20/SDIO_D0: U2.10 (PA5_A9_D9_MISO); also elsewhere on the board
GPIO21/SDIO_D1: U2.4 (PA11_A3_D3); also elsewhere on the board
GPIO22/SDIO_D2: U2.5 (PA8_A4_D4_SDA); also elsewhere on the board
GPIO23/SDIO_D3: U2.6 (PA9_A5_D5_SCL); also elsewhere on the board
unnamed: CHG1.1 (+), R11.1
unnamed: CHG1.2 (-), U3.B2 (NCHG)
unnamed: Q1.1 (G), R20.2
unnamed: D3.1, Q2.1 (G), R19.2
unnamed: R1.2, U1.C1 (MODE)
unnamed: L1.1, U1.B2 (SW)
unnamed: R10.2, U3.C1 (IREF)
unnamed: R3.2, USB1.A5 (A5/CC1)
unnamed: R6.1, USB1.B5 (B5/CC2)
VBAT: C9.1, Q1.3 (D), TP9.1 (T), U3.A1 (BAT)
VBUS: C2.1, C8.1, D1.1, D2.2, D3.2, Q2.3 (D), R9.2, R11.2, R20.1, U2.14 (5V), U3.A2 (VIN), USB1.A4_B9 (A4/B9/VBUS), USB1.B4_A9 (B4/A9/VBUS)

Notes on the sheet:
MTMS
MTDI
ICharge=24000/200K=120mA
GND
MTDO
Layout note: The position of the test points need to be the same as XIAO ESP32 S3
MTCK
BOOT
3V3

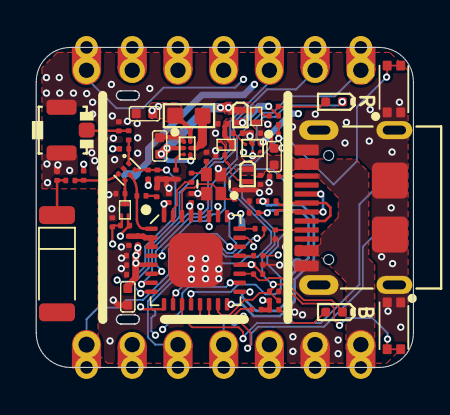
[picture p31: board XIAO ESP32 C6.kicad_pcb from above]

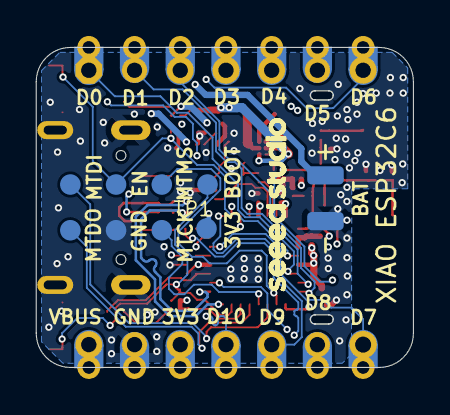
[picture p32: board XIAO ESP32 C6.kicad_pcb from below]

Board: 4 copper layers, 21.0 x 17.8 mm, 82 parts (10 on the bottom side), 53 nets.
