MitkoDyakov/Calipatron/Hardware/V2/Hardware V2.kicad_pcb

## KiCad design Hardware/V2/Hardware V2.kicad_pcb (2026-01-22)

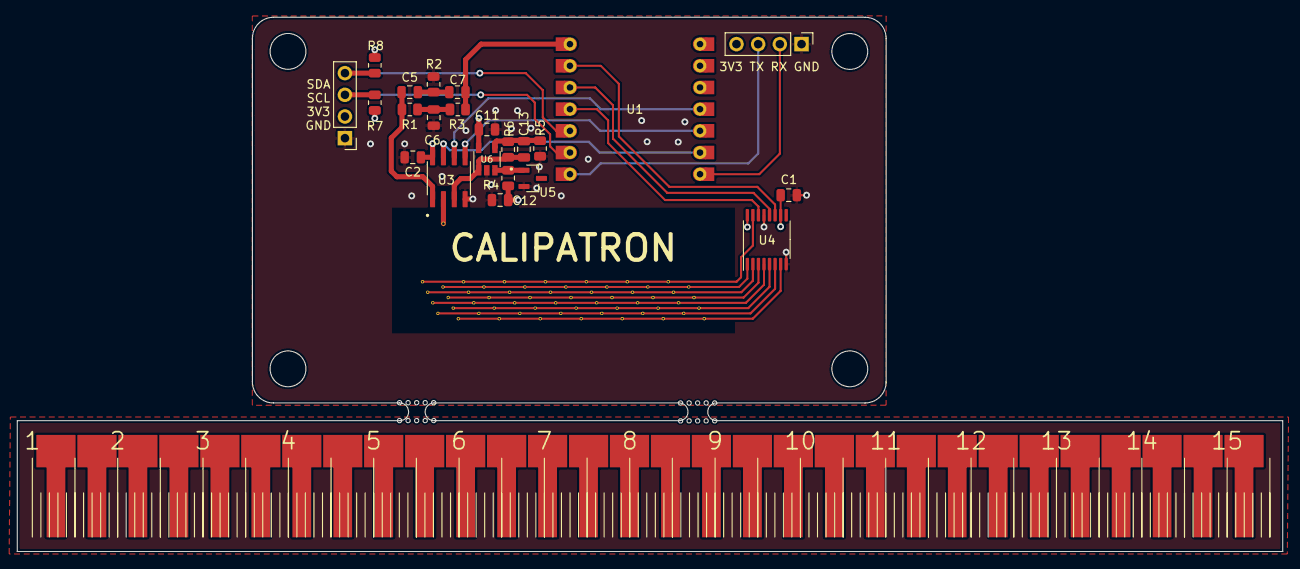
[picture p33: board Hardware V2.kicad_pcb from above]

Board: 4 copper layers, 148.3 x 62.6 mm, 24 parts (1 on the bottom side), 28 nets.

Parts:
C1, C2, C11, C12: 100nF; C_0805_2012Metric
C5, C7: 33nF; C_0805_2012Metric
C6: 47nF; C_0805_2012Metric
C13: NP; C_0805_2012Metric
J1, J2: Conn_01x04; PinHeader_1x04_P2.54mm_Vertical
R1, R3, R7, R8: 100K; R_0805_2012Metric
R2: 33K; R_0805_2012Metric
R4: 160R; R_0805_2012Metric
R5: 10K; R_0805_2012Metric
R6: 5K; R_0805_2012Metric
U1: XIAO; Mod
U2: signal_generator; excitation_electrodes
U3: MCP6S21-I_SN; SOIC127P600X175-8N
U4: 74HC595; TSSOP-16_4.4x5mm_P0.65mm
U5: ADR510ARTZ-REEL7; SOT95P237X112-3N
U6: AD8603; TSOT-23-5

Connections:
3V3: C1.2, C2.2, C11.2, C12.2, J1.2, J2.4, R4.1, R7.1, R8.1, U1.12, U3.8, U4.10, U4.16, U6.5
A+: U2.8, U4.15
A-: U2.4, U4.1
B+: U2.7, U4.2
B-: U2.3, U4.3
C+: U2.6, U4.4
C-: U2.2, U4.5
CS: U1.10, U3.5
D+: U2.5, U4.6
D-: U2.1, U4.7
GND: C1.1, C2.1, C6.2, C11.1, C12.1, J1.1, J2.1, R2.2, R5.2, U1.13, U3.4, U4.8, U4.13, U5.2, U6.2
unnamed: C5.1, C7.2, R2.1
unnamed: C5.2, R1.2, U3.1
unnamed: C6.1, R1.1, R3.2
unnamed: C13.2, R5.1, R6.2, U6.4
unnamed: R4.2, U5.1, U6.3
RCLK: U1.3, U4.12
RX: J2.2, U1.8
SCK: U1.9, U3.7
SCL: J1.3, R7.2, U1.6
SDA: J1.4, R8.2, U1.5
SENSE: U2.9, U3.2
SER: U1.4, U4.14
SI: U1.11, U3.6
SIGNAL: C7.1, R3.1, U1.1
SRCLK: U1.2, U4.11
TX: J2.3, U1.7
Vref: C13.1, R6.1, U3.3, U6.1
