MitkoDyakov/Calipatron/Software/Arduino/Base/Base.ino

#define NUMBER_OF_PUN_STATES  (128u)
#define SENSOR_PIN (1)

#define NODE_A (11)
#define NODE_B (9)
#define NODE_C (2)
#define NODE_D (4)

#define NODE_nA (10)
#define NODE_nB (8)
#define NODE_nC (3)
#define NODE_nD (7)

uint32_t pinState[NUMBER_OF_PUN_STATES] = {0b00000000010101010000000010101010, 0b00000000010101010000000010101010, 0b00000000011010100000000010010101, 0b00000000011010100000000010010101, 0b00000000010101010000000010101010, 0b00000000100101010000000001101010, 0b00000000011010100000000010010101, 0b00000000011010100000000010010101, 0b00000000010101010000000010101010, 0b00000000100101010000000001101010, 0b00000000011010100000000010010101, 0b00000000011010100000000010010101, 0b00000000100101010000000001101010, 0b00000000100101010000000001101010, 0b00000000010110100000000010100101, 0b00000000011010100000000010010101, 0b00000000100101010000000001101010, 0b00000000100101010000000001101010, 0b00000000010110100000000010100101, 0b00000000010110100000000010100101, 0b00000000100101010000000001101010, 0b00000000101001010000000001011010, 0b00000000010110100000000010100101, 0b00000000010110100000000010100101, 0b00000000100101010000000001101010, 0b00000000101001010000000001011010, 0b00000000010110100000000010100101, 0b00000000010110100000000010100101, 0b00000000101001010000000001011010, 0b00000000101001010000000001011010, 0b00000000010101100000000010101001, 0b00000000010110100000000010100101, 0b00000000101001010000000001011010, 0b00000000101001010000000001011010, 0b00000000010101100000000010101001, 0b00000000010101100000000010101001, 0b00000000101001010000000001011010, 0b00000000101010010000000001010110, 0b00000000010101100000000010101001, 0b00000000010101100000000010101001, 0b000000001010010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
  pinMode(USER_PIN, INPUT);
  attachInterrupt(digitalPinToInterrupt(USER_PIN), ISR_button_pressed, FALLING);

  // USB Serial port
  Serial.begin(115200);
  Serial.println("Setup is complete!");

  // Analog init
  // you can read the sensor output by analogRead(SENSOR_PIN)
}

void loop() {

}
