MitkoDyakov/Calipatron/Software/Test/Test.ioc

Mcu.UserName=STM32F103C8Tx
PA0-WKUP.Signal=GPIO_Output
PA1.Signal=GPIO_Output
PA10.Signal=GPIO_Output
PA11.Signal=USB_DM
PA12.Signal=USB_DP
PA13.Signal=SYS_JTMS-SWDIO
PA14.Signal=SYS_JTCK-SWCLK
PA2.Signal=GPIO_Output
PA3.Signal=GPIO_Output
PA4.Signal=GPIO_Output
PA5.Signal=GPIO_Output
PA6.Signal=GPIO_Output
PA7.Signal=GPIO_Output
PB1.Signal=ADCx_IN9
PB12.Signal=SPI2_NSS
PB13.Signal=SPI2_SCK
PB14.Signal=GPXTI14
PB15.Signal=SPI2_MOSI
PC14-OSC32_IN.Signal=RCC_OSC32_IN
PC15-OSC32_OUT.Signal=RCC_OSC32_OUT
PD0-OSC_IN.Signal=RCC_OSC_IN
PD1-OSC_OUT.Signal=RCC_OSC_OUT
