MitkoDyakov/Calipatron/Software/Test/Core/Src/main.c

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
/* Includes ------------------------------------------------------------------*/
#include "main.h"
#include "adc.h"
#include "dma.h"
#include "tim.h"
#include "usb_device.h"
#include "gpio.h"

/* USER CODE BEGIN Includes */

#include "ssd1306_fonts.h"
#include "usbd_cdc_if.h"
#include "notchFilter.h"
#include <string.h>
#include <stdio.h>

#define ADC_BUF_LEN (6072u)
volatile uint16_t adc_buf[ADC_BUF_LEN];

#define DISPLAY_ADDRESS_A (0x3Du)
#define DISPLAY_ADDRESS_B (0x3Cu) 

extern TIM_HandleTypeDef htim2;
extern TIM_HandleTypeDef htim1;
//extern I2C_HandleTypeDef hi2c1;
extern ADC_HandleTypeDef hadc1;

volatile uint8_t uartReadyFlag = 1;
volatile uint8_t adcReadyFlag = 1;
volatile uint16_t currentPinState = 0;
volatile uint8_t isAdcDmaStarted = 0;
volatile uint8_t startADC = 0;

#define PEAK (116u)
#define NUMBER_OF_PUN_STATES  (128u)
uint32_t pinState[NUMBER_OF_PUN_STATES] = {0b00000000011010100000000010010101, 0b00000000011010100000000010010101, 0b00000000010101010000000010101010, 0b00000000010101010000000010101010, 0b00000000101010100000000001010101, 0b00000000101010100000000001010101, 0b00000000010101010000000010101010, 0b00000000010101010000000010101010, 0b00000000101010100000000001010101, 0b00000000101010100000000001010101, 0b00000000010101010000000010101010, 0b00000000010101010000000010101010, 0b00000000101010100000000001010101, 0b00000000101010100000000001010101, 0b00000000010101010000000010101010, 0b00000000010101010000000010101010, 0b00000000101010100000000001010101, 0b00000000101010100000000001010101, 0b00000000010101100000000010101001, 0b00000000010101100000000010101001, 0b00000000101010010000000001010110, 0b00000000101010010000000001010110, 0b00000000010101100000000010101001, 0b00000000010101100000000010101001, 0b00000000101010010000000001010110, 0b00000000101010010000000001010110, 0b00000000010101100000000010101001, 0b00000000010101100000000010101001, 0b00000000101010010000000001010110, 0b00000000101010010000000001010110, 0b00000000010101100000000010101001, 0b00000000010101100000000010101001, 0b00000000101010010000000001010110, 0b00000000101010010000000001010110, 0b00000000010110100000000010100101, 0b00000000010110100000000010100101, 0b00000000101001010000000001011010, 0b00000000101001010000000001011010, 0b00000000010110100000000010100101, 0b00000000010110100000000010100101, 0b000000001010010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
        
        if(PEAK == currentPinState)
        {
            HAL_GPIO_WritePin(GPIOA, GPIO_PIN_10, GPIO_PIN_SET);
        }
        
        if((PEAK+5) == currentPinState)
        {
            HAL_GPIO_WritePin(GPIOA, GPIO_PIN_10, GPIO_PIN_RESET);
        }
    }
}

/* USER CODE END 0 */

/**
  * @brief  The application entry point.
  * @retval int
  */
int main(void)
{
  /* MCU Configuration--------------------------------------------------------*/

  /* Reset of all peripherals, Initializes the Flash interface and the Systick. */
  HAL_Init();

  /* Configure the system clock */
  SystemClock_Config();

  /* Initialize all configured peripherals */
  MX_GPIO_Init();
  MX_DMA_Init();
  MX_TIM2_Init();
  MX_ADC1_Init();
  MX_USB_DEVICE_Init();
  /* USER CODE BEGIN 2 */
    
  HAL_StatusTypeDef ret;

  TIM2->CCR1 = 1;  
  HAL_TIM_Base_Start_IT(&htim2);  
   
//  ret = HAL_I2C_IsDeviceReady(&hi2c1, DISPLAY_ADDRESS_B << 1, 5, HAL_MAX_DELAY);
//  
//  ssd1306_Init();
//  ssd1306_Fill(Black);
//  ssd1306_SetCursor(2, 2);
//  ssd1306_WriteString("Oops!", Font_16x26, White);
//  ssd1306_UpdateScreen();
  uint8_t msg[5] = {0};
  uint16_t i=0;
  
  HAL_ADCEx_Calibration_Start(&hadc1);

  /* USER CODE END 2 */

  /* Infinite loop */
  /* USER CODE BEGIN WHILE */
  while (1)
  {
    if(0 == uartReadyFlag)
    {
        for(i=0; i<ADC_BUF_LEN; i++)
        {
            memset(msg, 0, 5);
            sprintf(msg, "%d\r", adc_buf[i]);
            while(USBD_BUSY == CDC_Transmit_FS(msg, 5));
        }
        uartReadyFlag = 1;
        startADC = 0;
    }
    /* USER CODE END WHILE */

    /* USER CODE BEGIN 3 */
  }
  /* USER CODE END 3 */
}

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
