MitkoDyakov/Calipatron/(commit log)

2024-02-10 upload gerbers, and more docks
    [CaliperBlade-B_Cu.gbl, CaliperBlade-B_Mask.gbs, CaliperBlade-B_Paste.gbp, CaliperBlade-B_SilkS.gbo, CaliperBlade-Edge_Cuts.gm1, CaliperBlade-F_Cu.gtl, CaliperBlade-F_Mask.gts, CaliperBlade-F_Paste.gtp]
2024-02-10 update footprints
2024-02-12 upload 3d models
    [CaliperBlade.step, clip.step, clip.stl]
2024-04-25 upload kicad project
    [3-1437565-0.step, ABM3-10.0000MHZ-D2Y-T--3DModel-STEP-400430.STEP, CaliperBlade.kicad_pcb, CaliperBlade.sch, CaliperBlade.step, CaliperPCB.csv, CaliperPCB.kicad_pcb, CaliperPCB.sch]
2024-07-24 Initial arduino sketch
2024-09-15 update repo
    [BOM V1.2.csv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]
2024-09-15 update blade step
    [CaliperBlade.step]
2026-01-22 added kicad project
    [01 Descriptions.kicad_sch, 02 Block Diagram.kicad_sch, 03 Power.kicad_sch, 04 ESP32 C6.kicad_sch, 3-1437565-0.step, ABM3-10.0000MHZ-D2Y-T--3DModel-STEP-400430.STEP, ADR510ARTZ-REEL7.step, HRO_TYPE-C-31-M-12.step]
