MitkoDyakov/Calipatron/(notices)

Notices in the files:
Software/Test/Core/Src/main.c:
Copyright (c) 2024 STMicroelectronics.
All rights reserved.
This software is licensed under terms that can be found in the LICENSE file
Hardware/V2/Res/TSM-104-02-X-SH/TSM-104-02-X-SH.step:
author */ ('License CC BY-ND 4.0'),
